jarekkt/UniController/README.md

# UniController

This is a off-spin from my commercial controller for industrial ink printers.
It is designed for pick & place machines controlled by OpenPnp
