jarekkt/UniController/hardware/12_mixture/UniMixBase/refs/3D/MB1430-G431KBT6-A02.step

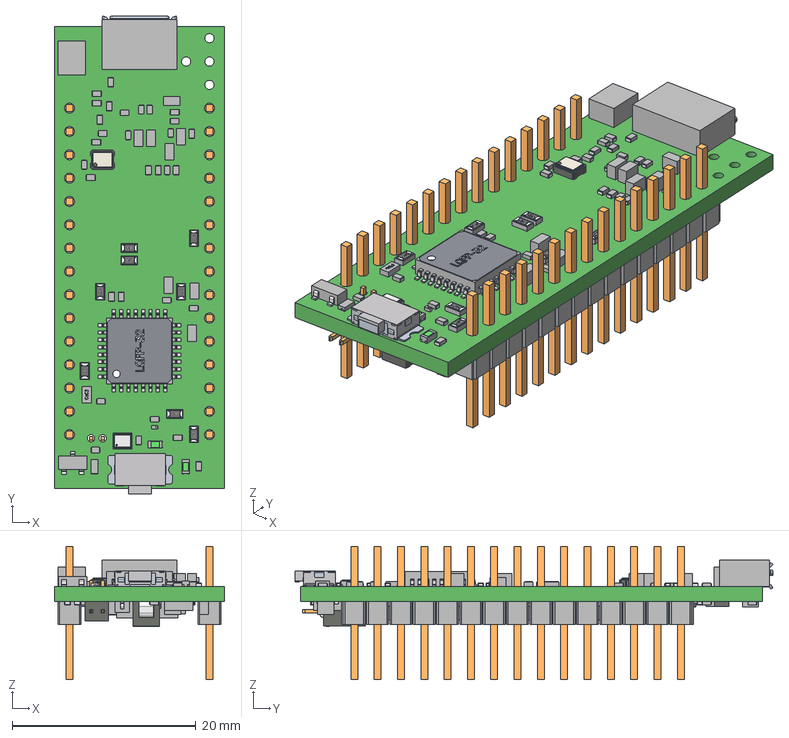
[picture p1: CAD file, 2025-05-28]
hardware/12_mixture/UniMixBase/refs/3D/MB1430-G431KBT6-A02.step
18.5 x 52.1 x 14.5 mm
Board
Extruded x 183
R0603 x 13
R0402 x 21
SOT23-3_TO-236AB
KSS221GLFS
NX2016
UFQFPN-32
SW3dPS-LQFP32_Board2 x 32
SW3dPS-LQFP32_Extruded15 x 32
SW3dPS-LQFP32_Extruded10
SW3dPS-LQFP32_Extruded16
SW3dPS-LQFP32_Extruded14
SW3dPS-LQFP32_Extruded11
SW3dPS-LQFP32_Extruded13
SW3dPS-LQFP32_Extruded19
SW3dPS-LQFP32_Extruded12
SW3dPS-LQFP32_Cylinder1
SW3dPS-LQFP32_Extruded18
SW3dPS-LQFP32_Extruded17
SW3dPS-LQFP32_Board3
DFN6-EPAD_3X3_P095
SOT223
SOT23-5L x 2
User_Library-LED_0603_G_Pocket002 x 2
User_Library-LED_0603_G_Pad004 x 2
User_Library-LED_0603_G_Fillet x 2
User_Library-LED_0603_G_Pocket001 x 2
User_Library-LED_0603_G_Pad x 2
LED_0603_RED_H0P4
L0603
SMA_DO214-AC
SOD323 x 3
C0402 x 32
C0603 x 13
C0805_2012D x 2
