jarekkt/UniController/hardware/12_mixture/UniMixBase/refs/3D/THVD1400DRLR.stp

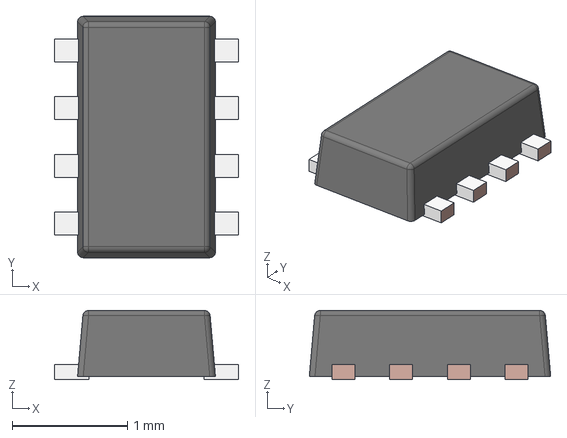
[picture p2: CAD file, 2025-02-07]
hardware/12_mixture/UniMixBase/refs/3D/THVD1400DRLR.stp
1.60 x 2.10 x 0.6 mm
FRAME-DRL0008A
BODY-SOT
