jarekkt/UniController/hardware/12_mixture/UniMixBase/refs/3D/XGZP6847A.STEP

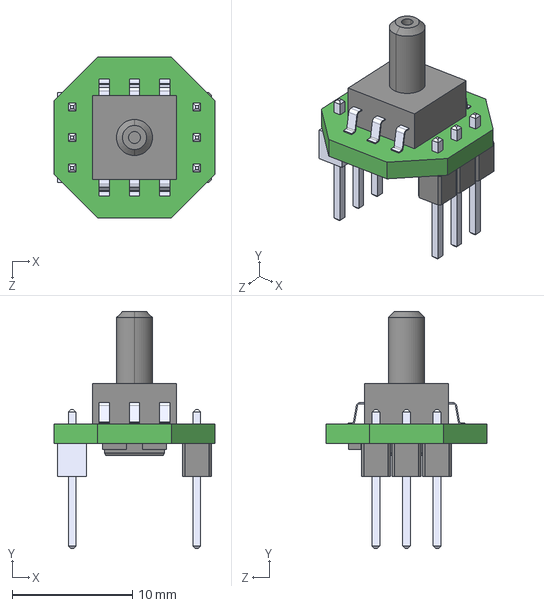
[picture p3: CAD file, 2025-02-07]
hardware/12_mixture/UniMixBase/refs/3D/XGZP6847A.STEP
13.4 x 19.7 x 13.3 mm
