jarekkt/UniController/hardware/12_mixture/UniMixBase/refs/3D/TMC2209_SILENTSTEPSTICK.step

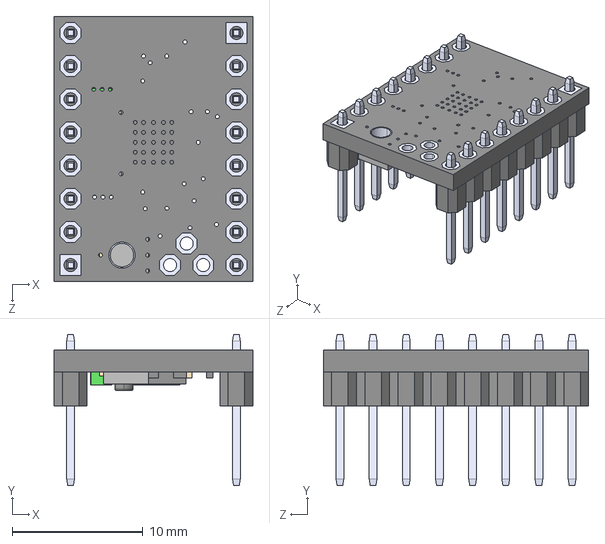
[picture p4: CAD file, 2025-02-07]
hardware/12_mixture/UniMixBase/refs/3D/TMC2209_SILENTSTEPSTICK.step
15.2 x 11.6 x 20.3 mm
