jarekkt/UniController/hardware/12_mixture/UniMixBase/refs/3D/3557-2.step

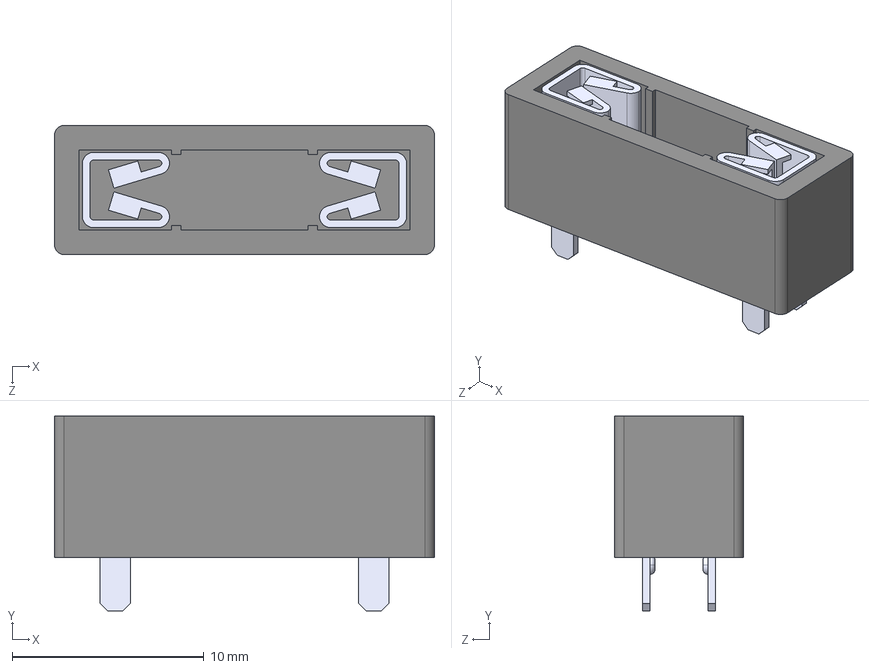
[picture p5: CAD file, 2025-02-07]
hardware/12_mixture/UniMixBase/refs/3D/3557-2.step
19.8 x 10.2 x 6.73 mm
