jarekkt/UniController/hardware/12_mixture/UniMixBase/refs/3D/LPC11C22FBD48_301,.stp

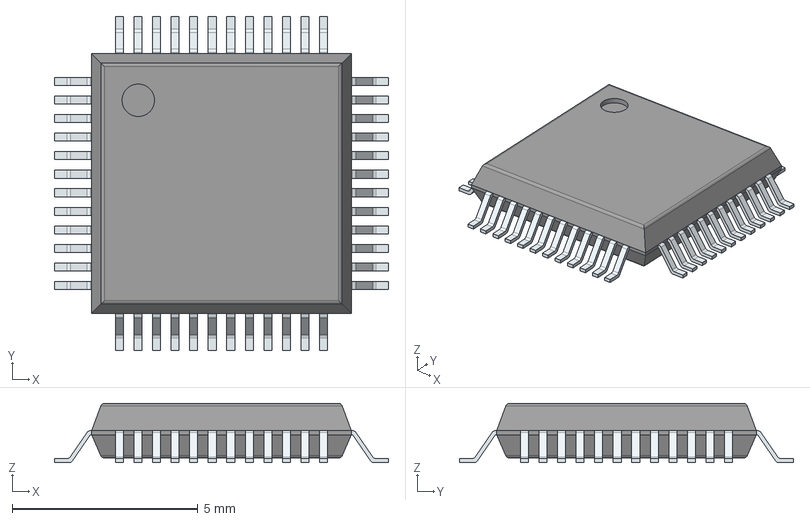
[picture p6: CAD file, 2025-02-07]
hardware/12_mixture/UniMixBase/refs/3D/LPC11C22FBD48_301,.stp
9.00 x 9.00 x 1.60 mm
PinsArrayLR
PinsArrayTB
