jarekkt/UniController/hardware/12_mixture/UniMixBase/refs/3D/D-SUN_dcdc_step_down_SIMPLE.step

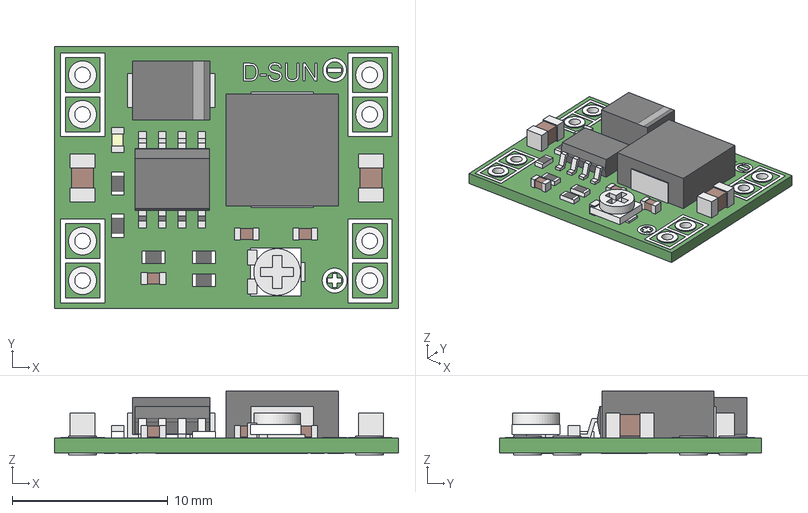
[picture p8: CAD file, 2025-02-07]
hardware/12_mixture/UniMixBase/refs/3D/D-SUN_dcdc_step_down_SIMPLE.step
22.1 x 16.8 x 4.10 mm
main001
silk-TOP
pins
silk-bot
comp-top
