jarekkt/UniController/hardware/12_mixture/UniMixBase/refs/3D/VNN3NV04PTR-E.stp

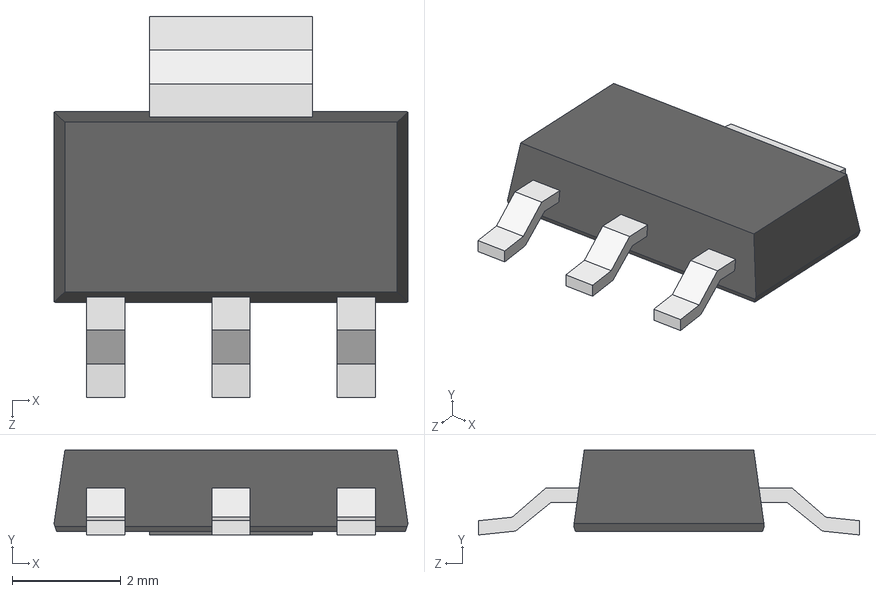
[picture p9: CAD file, 2025-02-07]
hardware/12_mixture/UniMixBase/refs/3D/VNN3NV04PTR-E.stp
6.50 x 1.56 x 7.00 mm
