jarekkt/UniController/hardware/12_mixture/UniMixBase/refs/3D/pxc_1990025_02_02_PTSA-0-5-4-2-5-Z_3D.stp

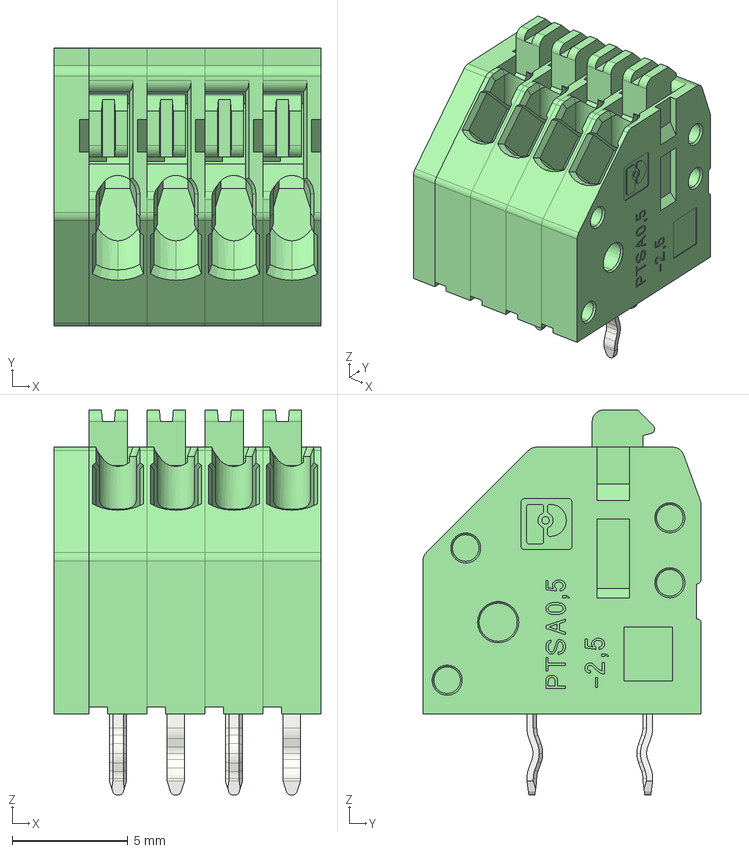
[picture p10: CAD file, 2025-02-07]
hardware/12_mixture/UniMixBase/refs/3D/pxc_1990025_02_02_PTSA-0-5-4-2-5-Z_3D.stp
11.5 x 12.0 x 16.6 mm
