jarekkt/UniController/hardware/12_mixture/UniMixBase/refs/3D/AP7375-50W5-7.stp

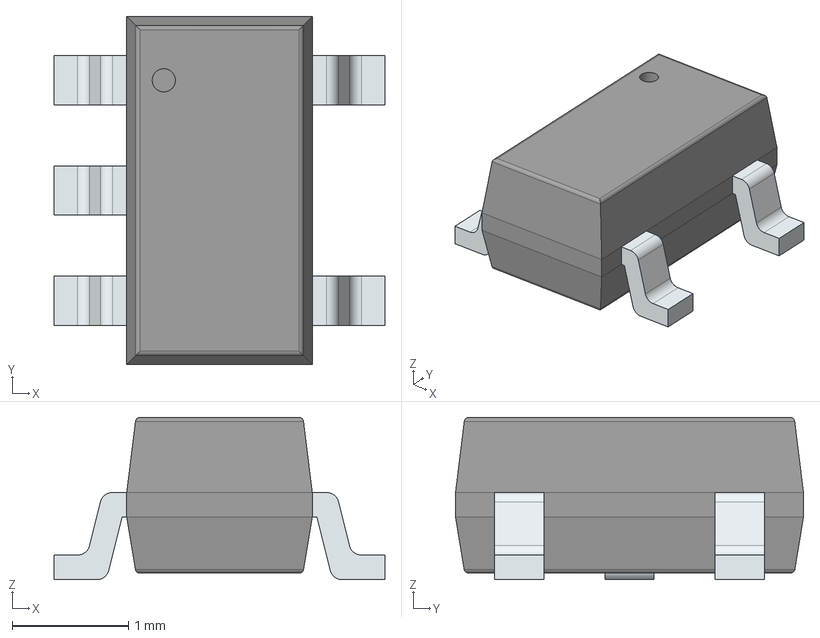
[picture p11: CAD file, 2024-10-20]
hardware/12_mixture/UniMixBase/refs/3D/AP7375-50W5-7.stp
2.85 x 3.00 x 1.40 mm
PinsArrayL
PinsArrayR
