jarekkt/UniController/hardware/12_mixture/UniMixBase/refs/3D/TMC2209-LA-T.stp

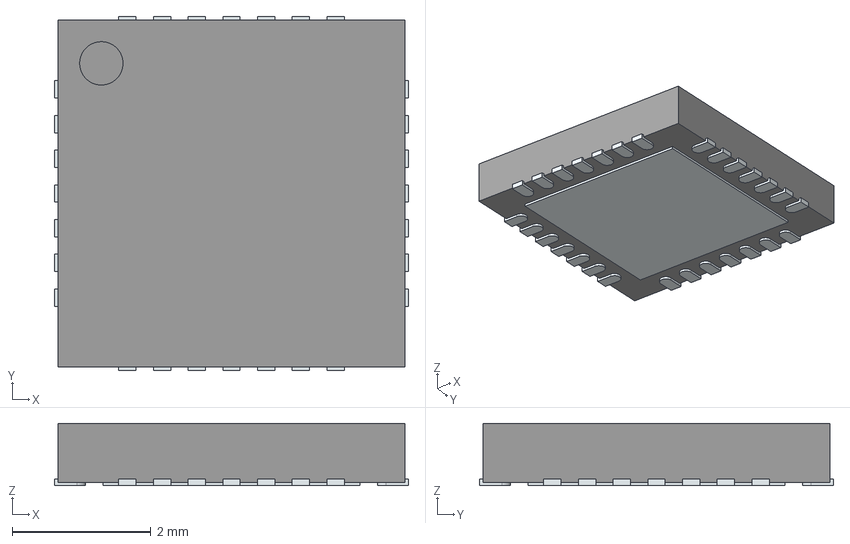
[picture p12: CAD file, 2024-10-20]
hardware/12_mixture/UniMixBase/refs/3D/TMC2209-LA-T.stp
5.10 x 5.10 x 0.9 mm
ThermalPin
PinsArrayLR
PinsArrayTB
