jarekkt/UniController/hardware/12_mixture/UniMixBase/refs/3D/05200101Z.stp

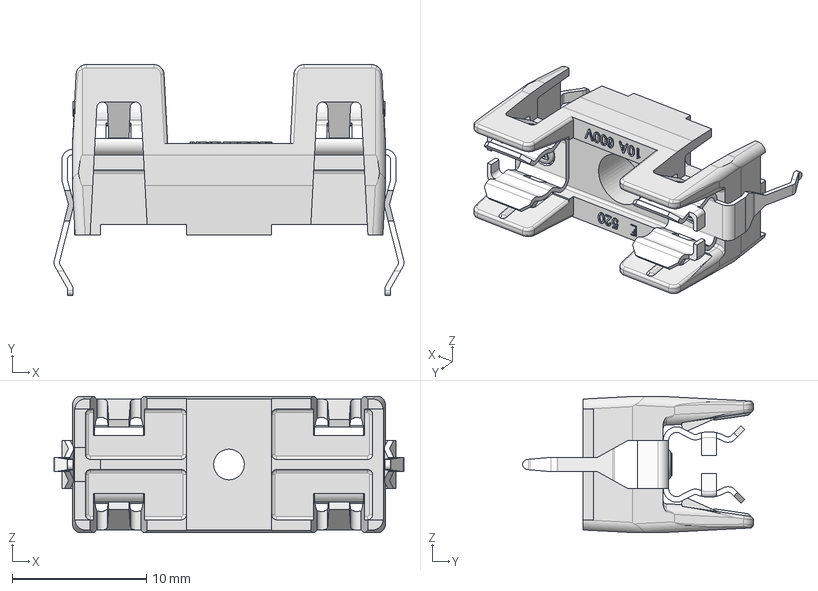
[picture p13: CAD file, 2025-02-07]
hardware/12_mixture/UniMixBase/refs/3D/05200101Z.stp
26.1 x 17.2 x 10.2 mm
111509_MIR
