jarekkt/UniController/hardware/12_mixture/UniMixHeadFd/UniMixHeadFd.kicad_pcb

## KiCad design hardware/12_mixture/UniMixHeadFd/UniMixHeadFd.kicad_pcb (2025-05-28)

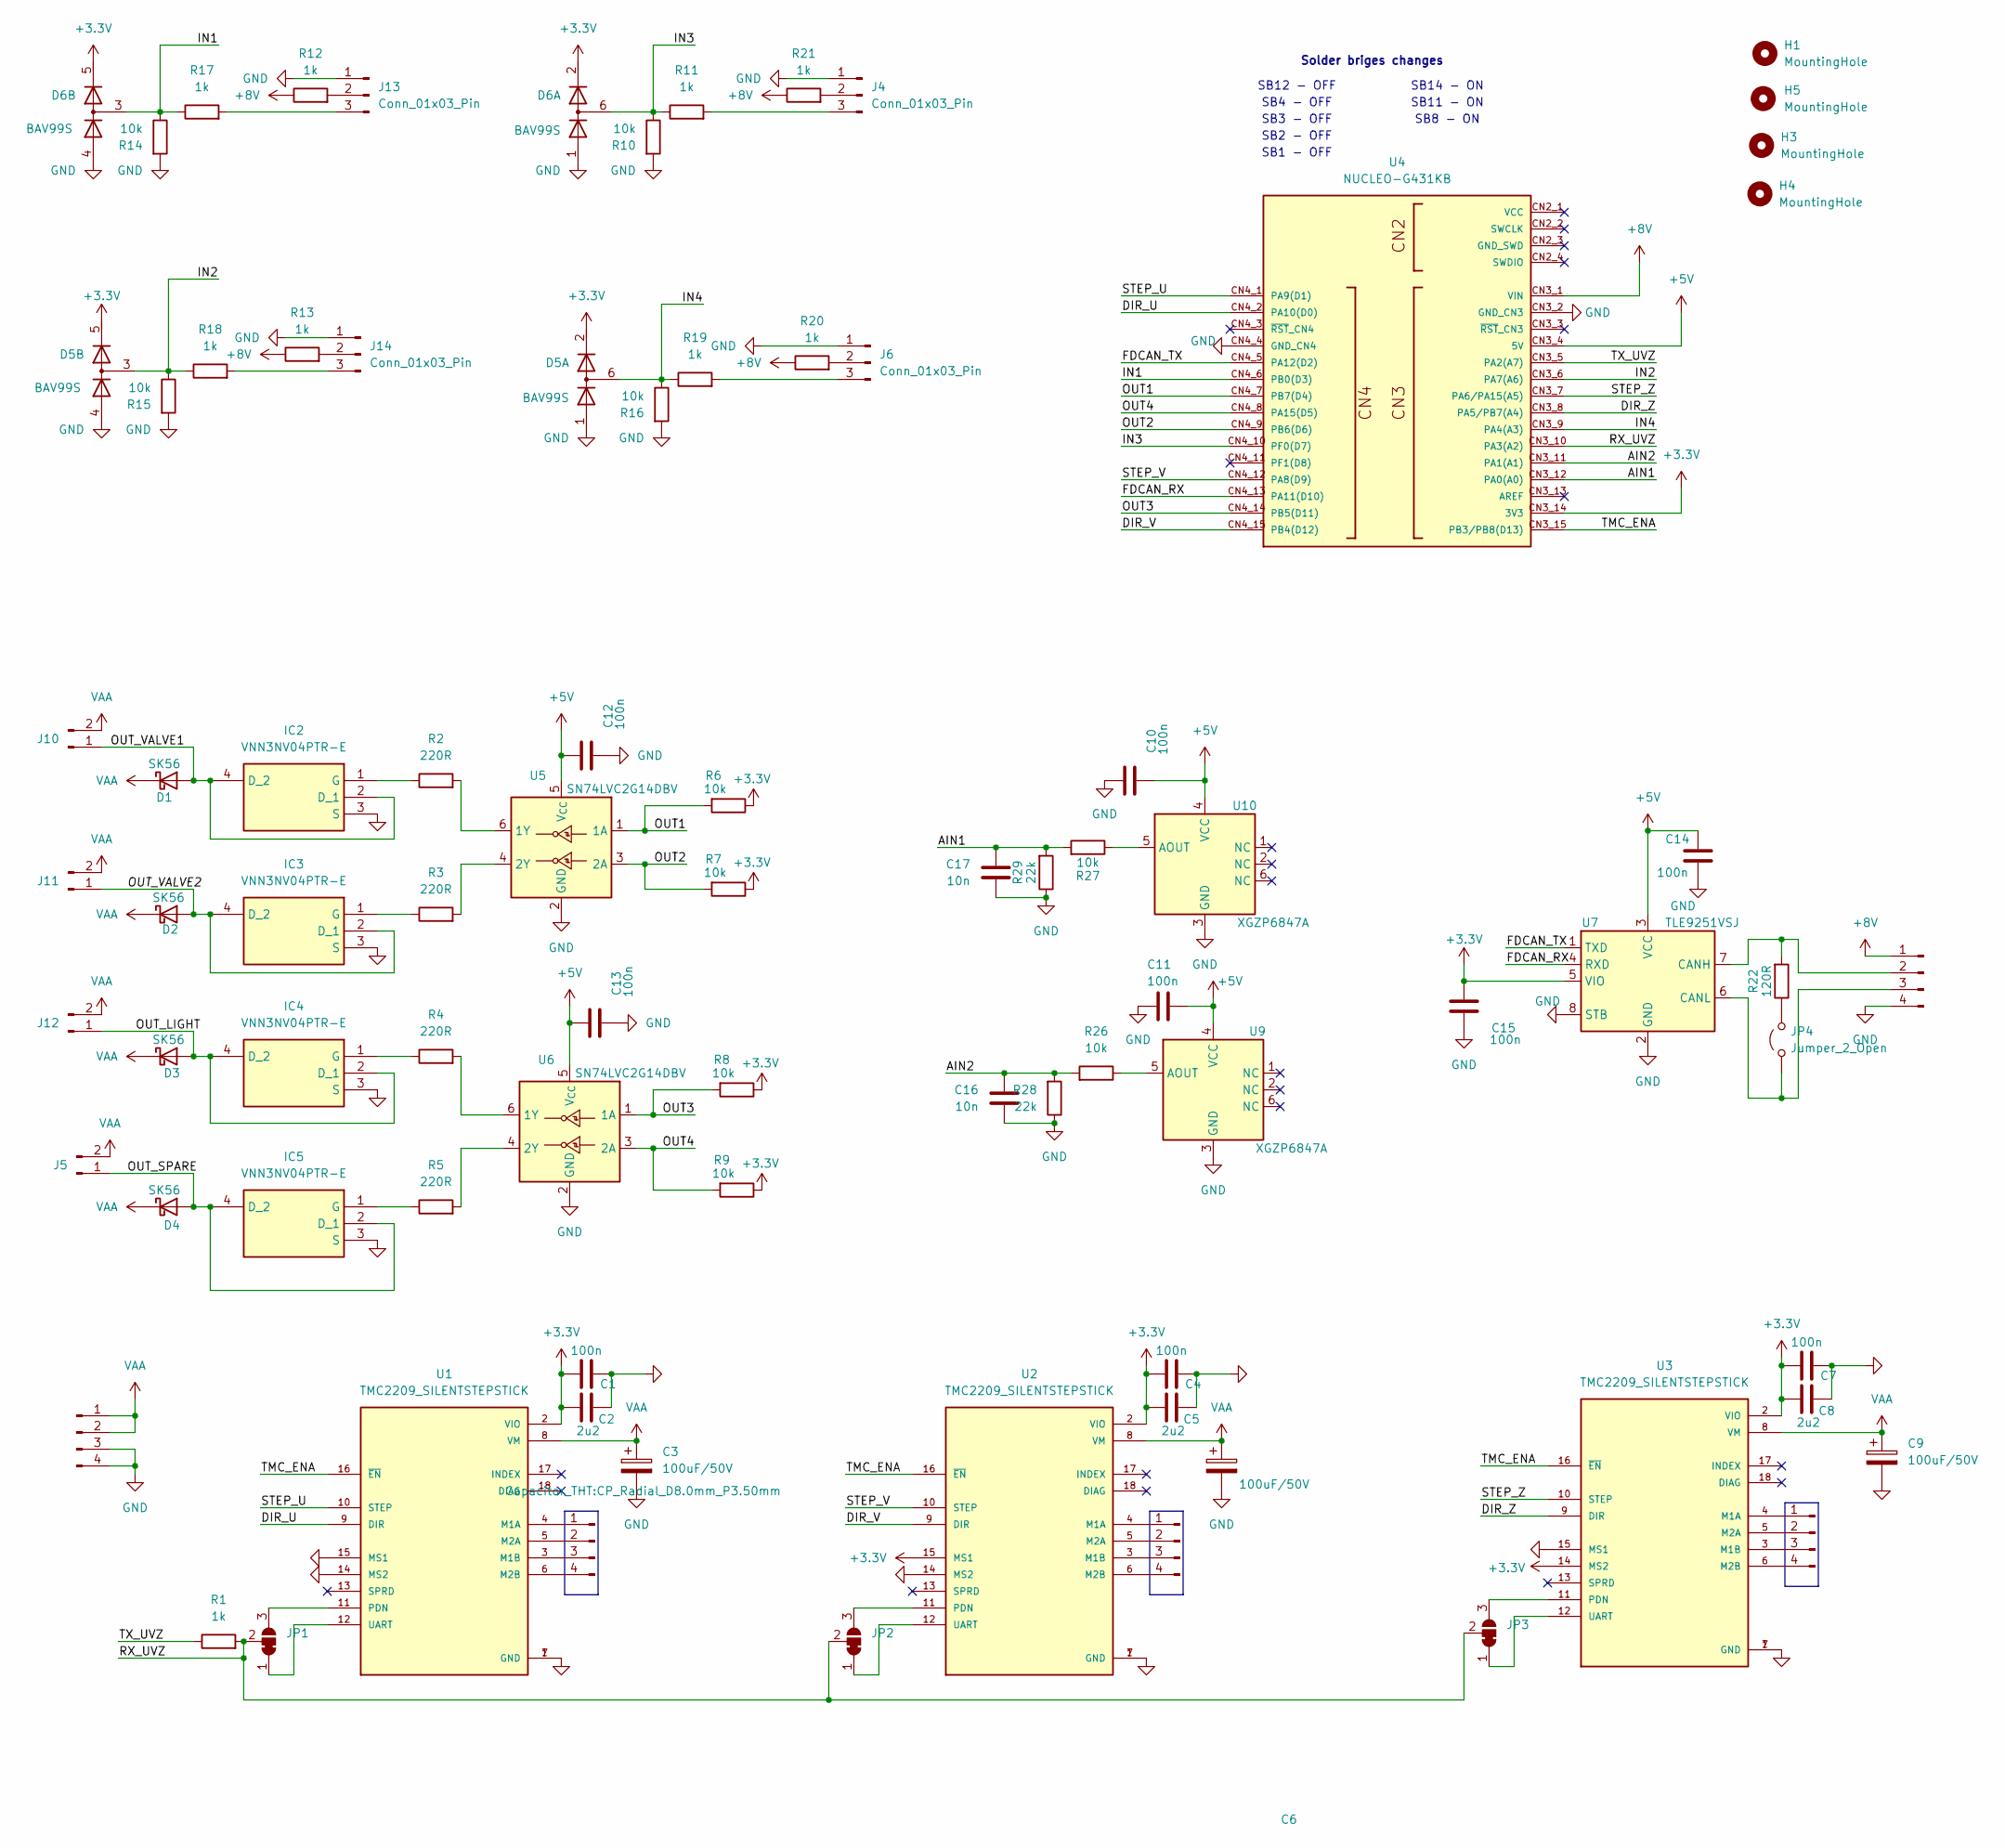
[picture p14: schematic UniMixHeadFd.kicad_sch]

Parts:
C1, C4, C7, C10, C11, C12, C13, C15: 100n; C_0603_1608Metric
C2, C5, C8: 2u2; C_0603_1608Metric
C3, C6, C9: 100uF/50V; CP_Radial_D8.0mm_P3.50mm
C14: 100n; C_0603_1608Metric; Digikey CC0402KRX7R7BB104
C16, C17: 10n; C_0603_1608Metric
D1, D2, D3, D4: SK56; D_SMB
D5, D6: BAV99S; SOT-363_SC-70-6
H1, H3, H4, H5: MountingHole; MountingHole_3.2mm_M3
IC2, IC3, IC4, IC5: VNN3NV04PTR-E; SOT230P700X180-4N; Manufacturer_Part_Number VNN3NV04PTR-E; Mouser Part Number 511-VNN3NV04PTR-E
J1, J2, J3, J25, J26: Conn_01x04_Male; JST_XH_B4B-XH-AM_1x04_P2.50mm_Vertical
J4, J6, J13, J14: Conn_01x03_Pin; JST_XH_B3B-XH-A_1x03_P2.50mm_Vertical
J5, J10, J11, J12: Conn_01x02_Male; JST_XH_B2B-XH-A_1x02_P2.50mm_Vertical
JP1, JP2, JP3: SolderJumper_3_Bridged12; SolderJumper-3_P1.3mm_Bridged12_RoundedPad1.0x1.5mm
JP4: Jumper_2_Open; SolderJumper-2_P1.3mm_Open_RoundedPad1.0x1.5mm
R1, R11, R12, R13, R17, R18, R19, R20, R21: 1k; R_0603_1608Metric
R2, R3, R4, R5: 220R; R_0603_1608Metric
R6, R7, R8, R9, R10, R14, R15, R16, R26, R27: 10k; R_0603_1608Metric
R22: 120R; R_1206_3216Metric
R28, R29: 22k; R_0603_1608Metric
U1, U2, U3: TMC2209_SILENTSTEPSTICK; MODULE_TMC2209_SILENTSTEPSTICK; PARTREV 1.20
U4: NUCLEO-G431KB; MODULE_NUCLEO-G431KB; PARTREV 2
U5, U6: SN74LVC2G14DBV; SOT-23-6
U7: TLE9251VSJ; SOIC-8_3.9x4.9mm_P1.27mm; Digikey TLE9251VSJXUMA1TR-ND
U9, U10: XGZP6847A; DIP-6_W10.16mm

Connections:
+3.3V: C1.2, C2.2, C4.2, C5.2, C7.2, C8.2, C15.1, D5.2 (K2), D5.5 (K4), D6.2 (K2), D6.5 (K4), R6.1, R7.1, R8.1, R9.1, U1.2 (VIO), U2.2 (VIO), U2.15 (MS1), U3.2 (VIO), U3.14 (MS2), U4.CN3_14 (3V3), U7.5 (VIO)
+5V: C10.2, C11.1, C12.1, C13.1, C14.1, U4.CN3_4 (5V), U5.5 (V_{CC}), U6.5 (V_{CC}), U7.3 (VCC), U9.4 (VCC), U10.4 (VCC)
+8V: J26.1, R12.1, R13.1, R20.1, R21.1, U4.CN3_1 (VIN)
/AIN1: C17.1, R27.2, R29.2, U4.CN3_12 (PA0(A0))
/AIN2: C16.1, R26.2, R28.2, U4.CN3_11 (PA1(A1))
/DIR_U: U1.9 (DIR), U4.CN4_2 (PA10(D0))
/DIR_V: U2.9 (DIR), U4.CN4_15 (PB4(D12))
/DIR_Z: U3.9 (DIR), U4.CN3_8 (PA5/PB7(A4))
/FDCAN_RX: U4.CN4_13 (PA11(D10)), U7.4 (RXD)
/FDCAN_TX: U4.CN4_5 (PA12(D2)), U7.1 (TXD)
/IN1: D6.3 (K1A2), R14.1, R17.1, U4.CN4_6 (PB0(D3))
/IN2: D5.3 (K1A2), R15.1, R18.1, U4.CN3_6 (PA7(A6))
/IN3: D6.6 (K3A4), R10.1, R11.1, U4.CN4_10 (PF0(D7))
/IN4: D5.6 (K3A4), R16.1, R19.1, U4.CN3_9 (PA4(A3))
/OUT1: R6.2, U4.CN4_7 (PB7(D4)), U5.1 (1A)
/OUT2: R7.2, U4.CN4_9 (PB6(D6)), U5.3 (2A)
/OUT3: R8.2, U4.CN4_14 (PB5(D11)), U6.1 (1A)
/OUT4: R9.2, U4.CN4_8 (PA15(D5)), U6.3 (2A)
/OUT_LIGHT: D3.2 (A), IC4.2 (D_1), IC4.4 (D_2), J12.1
/OUT_SPARE: D4.2 (A), IC5.2 (D_1), IC5.4 (D_2), J5.1
/OUT_VALVE1: D1.2 (A), IC2.2 (D_1), IC2.4 (D_2), J10.1
/OUT_VALVE2: D2.2 (A), IC3.2 (D_1), IC3.4 (D_2), J11.1
/RX_UVZ: JP1.2 (C), JP2.2 (C), JP3.2 (C), R1.2, U4.CN3_10 (PA3(A2))
/STEP_U: U1.10 (STEP), U4.CN4_1 (PA9(D1))
/STEP_V: U2.10 (STEP), U4.CN4_12 (PA8(D9))
/STEP_Z: U3.10 (STEP), U4.CN3_7 (PA6/PA15(A5))
/TMC_ENA: U1.16 (~EN), U2.16 (~EN), U3.16 (~EN), U4.CN3_15 (PB3/PB8(D13))
/TX_UVZ: R1.1, U4.CN3_5 (PA2(A7))
GND: C1.1, C2.1, C3.2, C4.1, C5.1, C6.2, C7.1, C8.1, C9.2, C10.1, C11.2, C12.2, C13.2, C14.2, C15.2, C16.2, C17.2, D5.1 (A1), D5.4 (A3), D6.1 (A1), D6.4 (A3), IC2.3 (S), IC3.3 (S), IC4.3 (S), IC5.3 (S), J4.1, J6.1, J13.1, J14.1, J25.3, J25.4, J26.4, R10.2, R14.2, R15.2, R16.2, R28.1, R29.1, U1.1 (GND), U1.7 (GND), U1.14 (MS2), U1.15 (MS1), U2.1 (GND), U2.7 (GND), U2.14 (MS2), U3.1 (GND), U3.7 (GND), U3.15 (MS1), U4.CN3_2 (GND_CN3), U4.CN4_4 (GND_CN4), U5.2 (GND), U6.2 (GND), U7.2 (GND), U7.8 (STB), U9.3 (GND), U10.3 (GND)
unnamed: IC2.1 (G), R2.1
unnamed: IC3.1 (G), R3.1
unnamed: IC4.1 (G), R4.1
unnamed: IC5.1 (G), R5.1
unnamed: J1.1, U1.4 (M1A)
unnamed: J1.2, U1.5 (M2A)
unnamed: J1.3, U1.3 (M1B)
unnamed: J1.4, U1.6 (M2B)
unnamed: J2.1, U2.4 (M1A)
unnamed: J2.2, U2.5 (M2A)
unnamed: J2.3, U2.3 (M1B)
unnamed: J2.4, U2.6 (M2B)
unnamed: J3.1, U3.4 (M1A)
unnamed: J3.2, U3.5 (M2A)
unnamed: J3.3, U3.3 (M1B)
unnamed: J3.4, U3.6 (M2B)
unnamed: J4.2, R21.2
unnamed: J4.3, R11.2
unnamed: J6.2, R20.2
unnamed: J6.3, R19.2
unnamed: J13.2, R12.2
unnamed: J13.3, R17.2
unnamed: J14.2, R13.2
unnamed: J14.3, R18.2
unnamed: J26.2, R22.2, U7.7 (CANH)
unnamed: J26.3, JP4.1 (A), U7.6 (CANL)
unnamed: JP1.1 (A), U1.12 (UART)
unnamed: JP1.3 (B), U1.11 (PDN)
unnamed: JP2.1 (A), U2.12 (UART)
unnamed: JP2.3 (B), U2.11 (PDN)
unnamed: JP3.1 (A), U3.12 (UART)
unnamed: JP3.3 (B), U3.11 (PDN)
unnamed: JP4.2 (B), R22.1
unnamed: R2.2, U5.6 (1Y)
unnamed: R3.2, U5.4 (2Y)
unnamed: R4.2, U6.6 (1Y)
unnamed: R5.2, U6.4 (2Y)
unnamed: R26.1, U9.5 (AOUT)
unnamed: R27.1, U10.5 (AOUT)
VAA: C3.1, C6.1, C9.1, D1.1 (K), D2.1 (K), D3.1 (K), D4.1 (K), J5.2, J10.2, J11.2, J12.2, J25.1, J25.2, U1.8 (VM), U2.8 (VM), U3.8 (VM)

Notes on the sheet:
SB8 - ON
SB3 - OFF
SB14 - ON
SB1 - OFF
SB11 - ON
SB4 - OFF
SB2 - OFF
SB12 - OFF
Solder briges changes

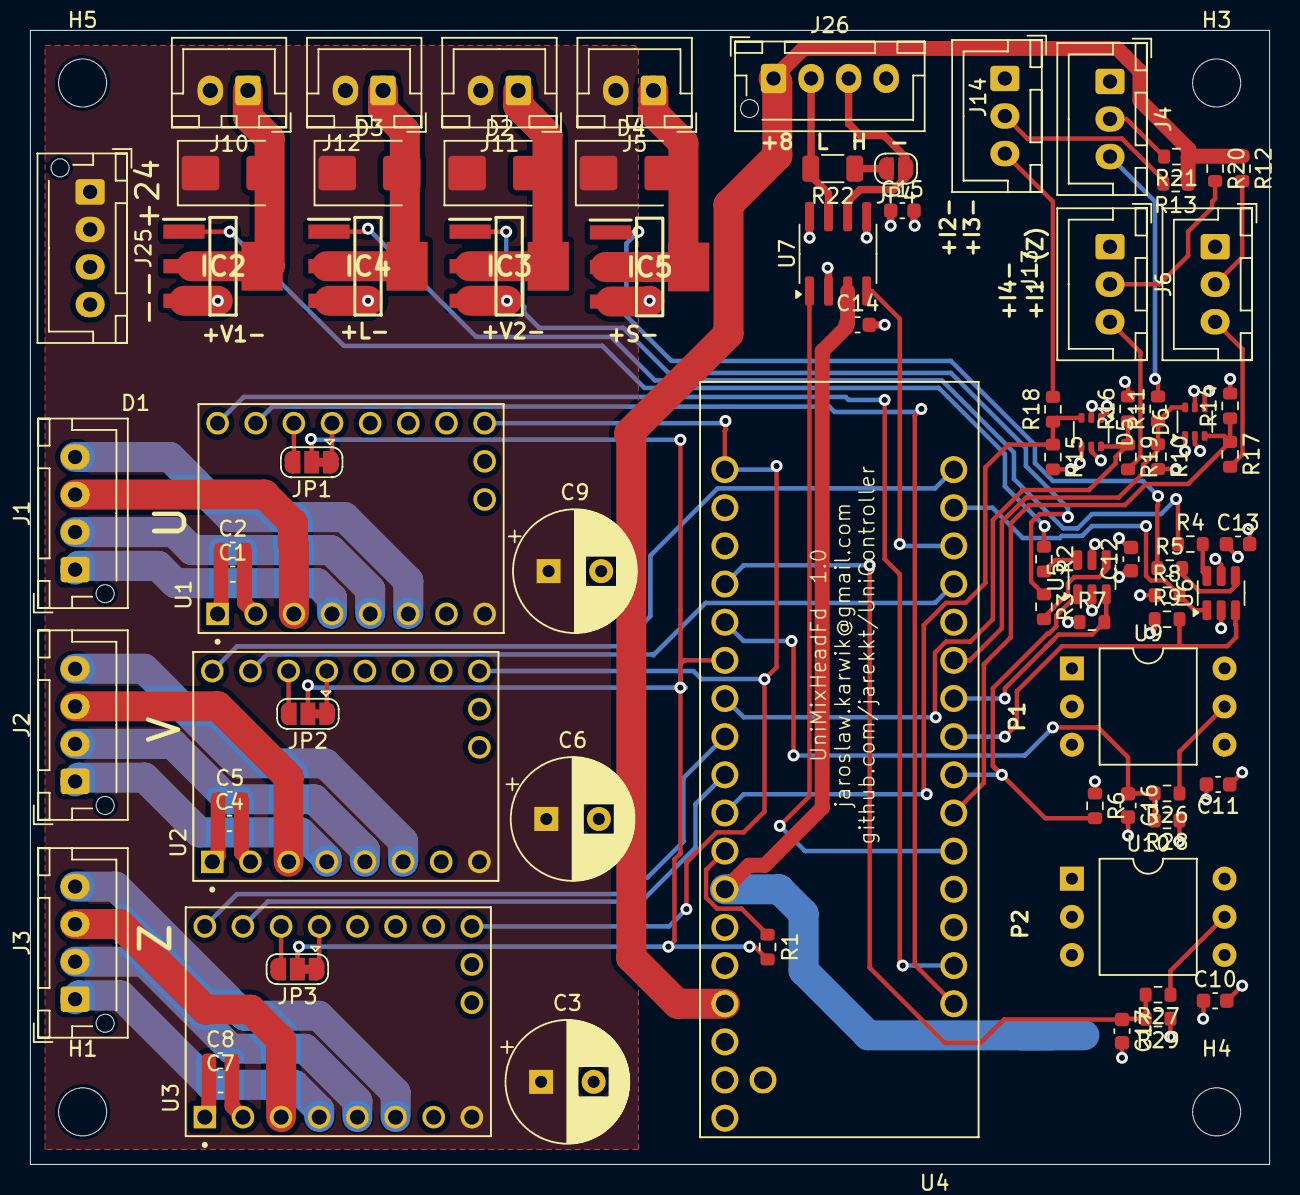
[picture p15: board UniMixHeadFd.kicad_pcb from above]

Board: 4 copper layers, 82.5 x 75.5 mm, 83 parts (0 on the bottom side), 69 nets.
