jarekkt/UniController/hardware/12_mixture/UniMixFeeders/UniMixFeeders.kicad_pcb

## KiCad design hardware/12_mixture/UniMixFeeders/UniMixFeeders.kicad_pcb (2025-05-28)

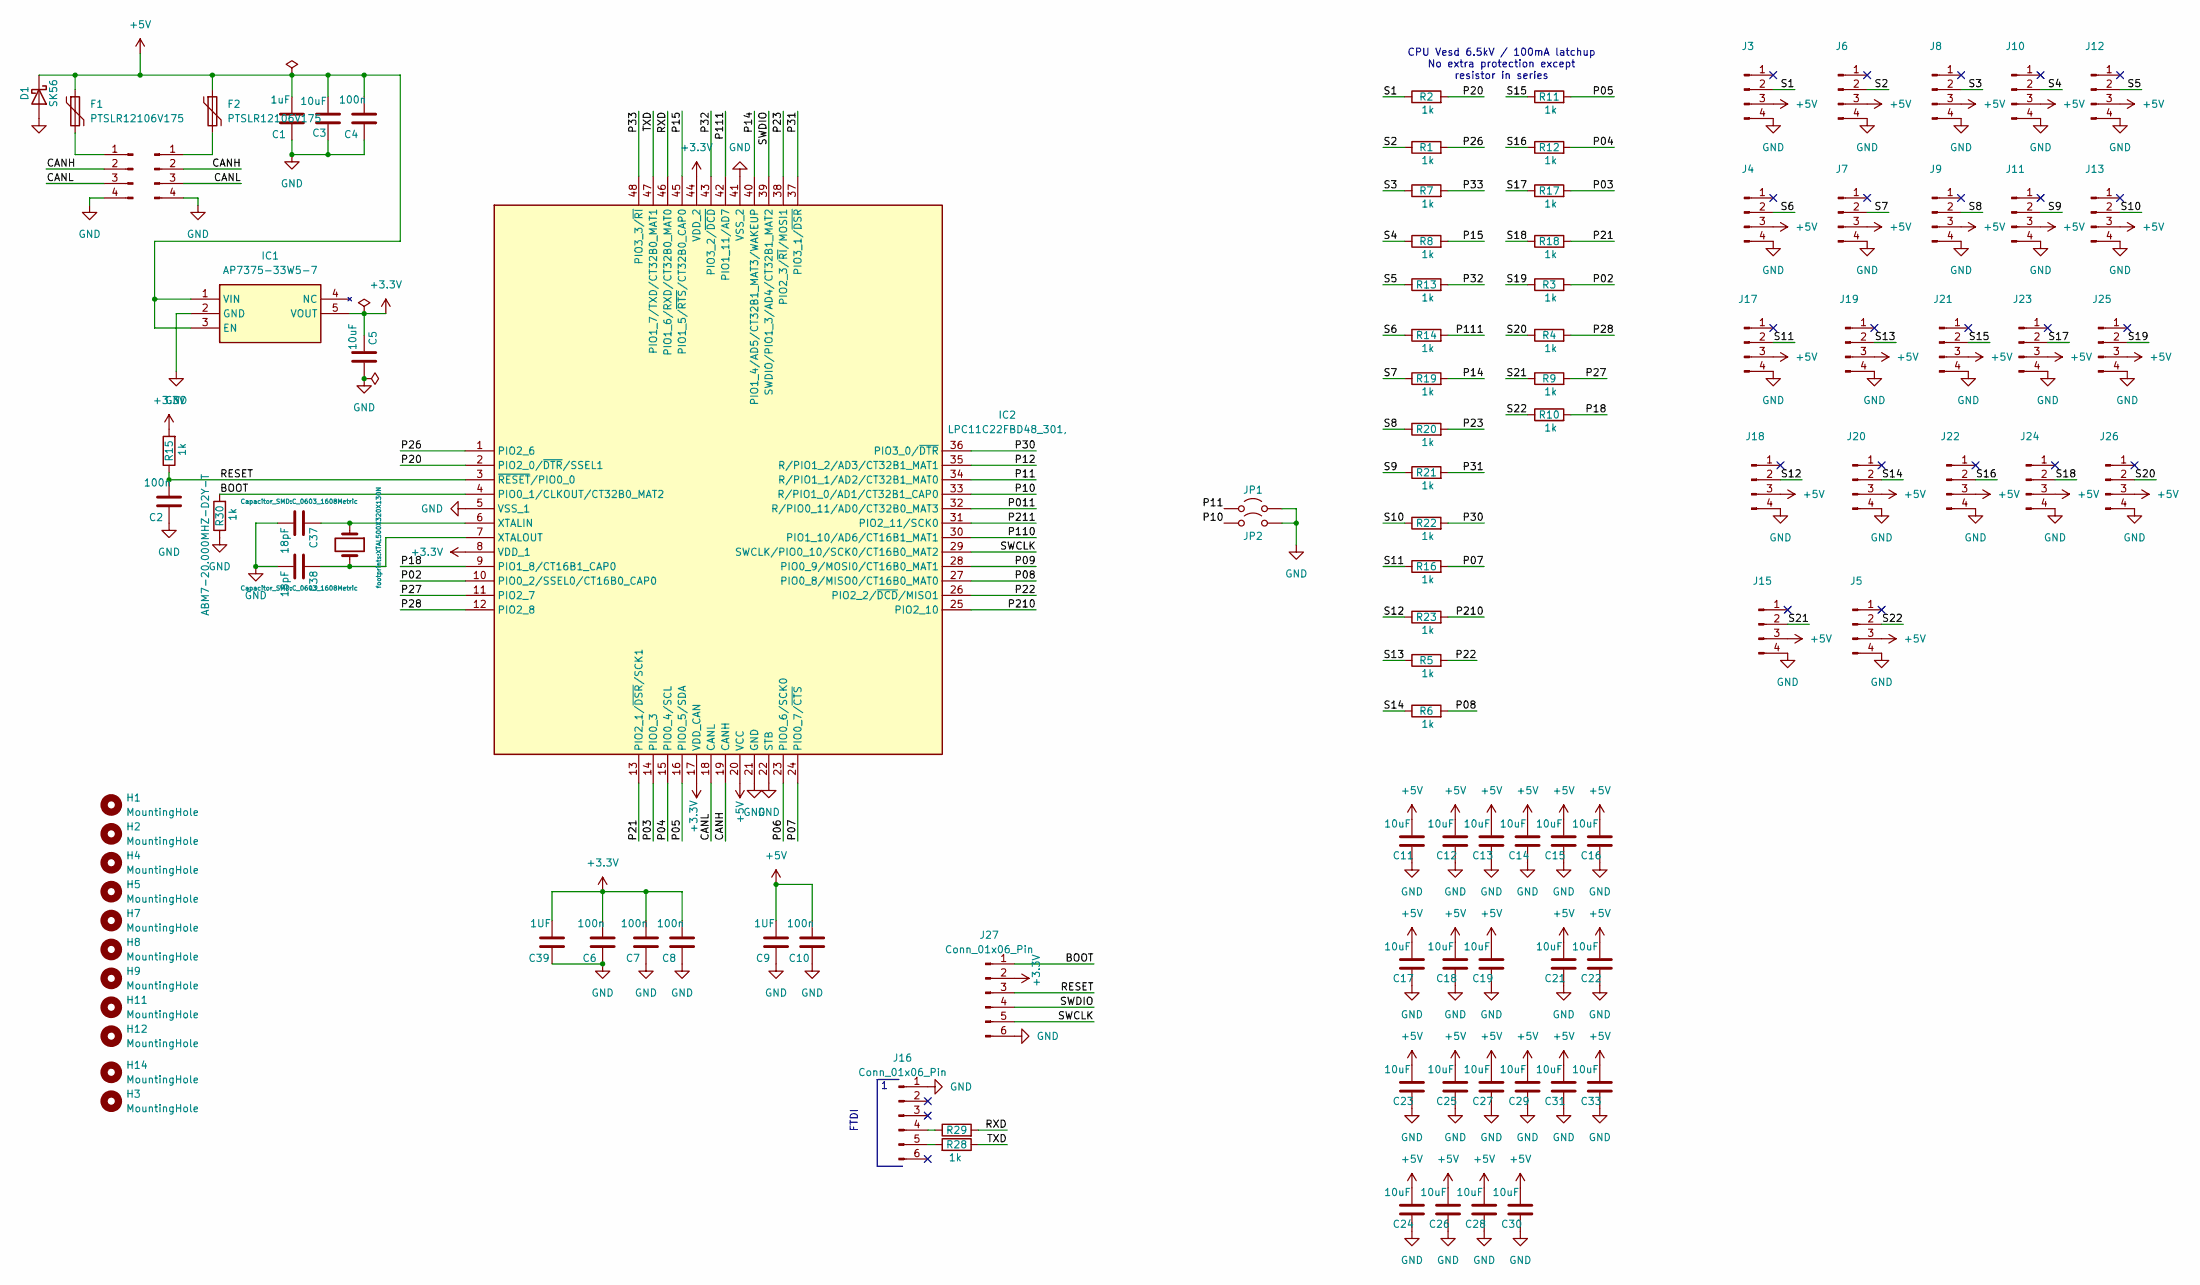
[picture p16: schematic UniMixFeeders.kicad_sch]

Parts:
C1: 1uF; C_0603_1608Metric
C2, C4, C6, C7, C8, C10: 100n; C_0603_1608Metric
C3, C5, C11, C12, C13, C14, C15, C16, C17, C18, C19, C21, C22, C23, C24, C25, C26, C27, C28, C29, C30, C31, C33: 10uF; C_1206_3216Metric
C9, C39: 1UF; C_0603_1608Metric
C37, C38: 18pF; C_0603_1608Metric
D1: SK56; D_SMB
F1, F2: PTSLR12106V175; Fuse_1210_3225Metric
H1, H2, H3, H4, H5, H7, H8, H9, H11, H12, H14: MountingHole; MountingHole_3.2mm_M3
IC1: AP7375-33W5-7; SOT95P285X140-5N
IC2: LPC11C22FBD48_301,; QFP50P900X900X160-48N; Manufacturer_Part_Number LPC11C22FBD48/301,; Mouser Part Number 771-LPC11C22FBD4830
J1, J2: Conn_01x04_Male; JST_XH_B4B-XH-AM_1x04_P2.50mm_Vertical
J3, J4, J5, J6, J7, J8, J9, J10, J11, J12, J13, J15, J17, J18, J19, J20, J21, J22, J23, J24, J25, J26: Conn_01x04_Pin; PinHeader_1x04_P2.54mm_Vertical
J16: Conn_01x06_Pin; PinHeader_1x06_P2.54mm_Vertical
J27: Conn_01x06_Pin; PinHeader_2x03_P2.54mm_Vertical
JP1, JP2: Jumper_2_Open; SolderJumper-2_P1.3mm_Open_RoundedPad1.0x1.5mm
R1, R2, R3, R4, R5, R6, R7, R8, R9, R10, R11, R12, R13, R14, R15, R16, R17, R18, R19, R20, R21, R22, R23, R28, R29, R30: 1k; R_0603_1608Metric
Y1: ABM7-20.000MHZ-D2Y-T; XTAL500X320X130N; Digikey 535-9843-2-ND

Connections:
+3.3V: C5.1, C6.1, C7.1, C8.1, C39.1, IC1.5 (VOUT), IC2.8 (VDD_1), IC2.17 (VDD_CAN), IC2.44 (VDD_2), J27.2, R15.2
+5V: C1.1, C3.1, C4.1, C9.1, C10.1, C11.1, C12.1, C13.1, C14.1, C15.1, C16.1, C17.1, C18.1, C19.1, C21.1, C22.1, C23.1, C24.1, C25.1, C26.1, C27.1, C28.1, C29.1, C30.1, C31.1, C33.1, D1.1 (K), F1.1, F2.1, IC1.1 (VIN), IC1.3 (EN), IC2.20 (VCC), J3.3, J4.3, J5.3, J6.3, J7.3, J8.3, J9.3, J10.3, J11.3, J12.3, J13.3, J15.3, J17.3, J18.3, J19.3, J20.3, J21.3, J22.3, J23.3, J24.3, J25.3, J26.3
/BOOT: IC2.4 (PIO0_1/CLKOUT/CT32B0_MAT2), J27.1, R30.2
/CANH: IC2.19 (CANH), J1.2, J2.2
/CANL: IC2.18 (CANL), J1.3, J2.3
/P02: IC2.10 (PIO0_2/SSEL0/CT16B0_CAP0), R3.2
/P03: IC2.14 (PIO0_3), R17.2
/P04: IC2.15 (PIO0_4/SCL), R12.2
/P05: IC2.16 (PIO0_5/SDA), R11.2
/P06: IC2.23 (PIO0_6/SCK0)
/P07: IC2.24 (PIO0_7/~CTS), R16.2
/P08: IC2.27 (PIO0_8/MISO0/CT16B0_MAT0), R6.2
/P09: IC2.28 (PIO0_9/MOSI0/CT16B0_MAT1)
/P10: IC2.33 (R/PIO1_0/AD1/CT32B1_CAP0), JP2.1 (A)
/P011: IC2.32 (R/PIO0_11/AD0/CT32B0_MAT3)
/P11: IC2.34 (R/PIO1_1/AD2/CT32B1_MAT0), JP1.1 (A)
/P12: IC2.35 (R/PIO1_2/AD3/CT32B1_MAT1)
/P14: IC2.40 (PIO1_4/AD5/CT32B1_MAT3/WAKEUP), R19.2
/P15: IC2.45 (PIO1_5/~RTS/CT32B0_CAP0), R8.2
/P18: IC2.9 (PIO1_8/CT16B1_CAP0), R10.2
/P20: IC2.2 (PIO2_0/~DTR/SSEL1), R2.2
/P21: IC2.13 (PIO2_1/~DSR/SCK1), R18.2
/P22: IC2.26 (PIO2_2/~DCD/MISO1), R5.2
/P23: IC2.38 (PIO2_3/~RI/MOSI1), R20.2
/P26: IC2.1 (PIO2_6), R1.2
/P27: IC2.11 (PIO2_7), R9.2
/P28: IC2.12 (PIO2_8), R4.2
/P30: IC2.36 (PIO3_0/~DTR), R22.2
/P31: IC2.37 (PIO3_1/~DSR), R21.2
/P32: IC2.43 (PIO3_2/~DCD), R13.2
/P33: IC2.48 (PIO3_3/~RI), R7.2
/P110: IC2.30 (PIO1_10/AD6/CT16B1_MAT1)
/P111: IC2.42 (PIO1_11/AD7), R14.2
/P210: IC2.25 (PIO2_10), R23.2
/P211: IC2.31 (PIO2_11/SCK0)
/RESET: C2.1, IC2.3 (~RESET/PIO0_0), J27.3, R15.1
/RXD: IC2.46 (PIO1_6/RXD/CT32B0_MAT0), R29.2
/S1: J3.2, R2.1
/S2: J6.2, R1.1
/S3: J8.2, R7.1
/S4: J10.2, R8.1
/S5: J12.2, R13.1
/S6: J4.2, R14.1
/S7: J7.2, R19.1
/S8: J9.2, R20.1
/S9: J11.2, R21.1
/S10: J13.2, R22.1
/S11: J17.2, R16.1
/S12: J18.2, R23.1
/S13: J19.2, R5.1
/S14: J20.2, R6.1
/S15: J21.2, R11.1
/S16: J22.2, R12.1
/S17: J23.2, R17.1
/S18: J24.2, R18.1
/S19: J25.2, R3.1
/S20: J26.2, R4.1
/S21: J15.2, R9.1
/S22: J5.2, R10.1
/SWCLK: IC2.29 (SWCLK/PIO0_10/SCK0/CT16B0_MAT2), J27.5
/SWDIO: IC2.39 (SWDIO/PIO1_3/AD4/CT32B1_MAT2), J27.4
/TXD: IC2.47 (PIO1_7/TXD/CT32B0_MAT1), R28.1
GND: C1.2, C2.2, C3.2, C4.2, C5.2, C6.2, C7.2, C8.2, C9.2, C10.2, C11.2, C12.2, C13.2, C14.2, C15.2, C16.2, C17.2, C18.2, C19.2, C21.2, C22.2, C23.2, C24.2, C25.2, C26.2, C27.2, C28.2, C29.2, C30.2, C31.2, C33.2, C37.2, C38.2, C39.2, D1.2 (A), IC1.2 (GND), IC2.5 (VSS_1), IC2.21 (GND), IC2.22 (STB), IC2.41 (VSS_2), J1.4, J2.4, J3.4, J4.4, J5.4, J6.4, J7.4, J8.4, J9.4, J10.4, J11.4, J12.4, J13.4, J15.4, J16.1, J17.4, J18.4, J19.4, J20.4, J21.4, J22.4, J23.4, J24.4, J25.4, J26.4, J27.6, JP1.2 (B), JP2.2 (B), R30.1
unnamed: C37.1, IC2.6 (XTALIN), Y1.1
unnamed: C38.1, IC2.7 (XTALOUT), Y1.2
unnamed: F1.2, J1.1
unnamed: F2.2, J2.1
unnamed: J16.4, R29.1
unnamed: J16.5, R28.2

Notes on the sheet:
CPU Vesd 6.5kV / 100mA latchup No extra protection except resistor in series
FTDI

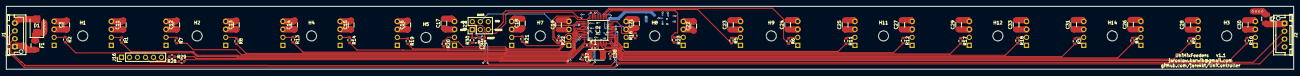
[picture p17: board UniMixFeeders.kicad_pcb from above]

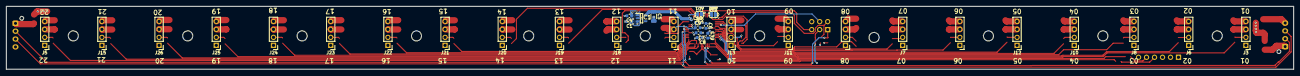
[picture p18: board UniMixFeeders.kicad_pcb from below]

Board: 4 copper layers, 409.6 x 20.0 mm, 105 parts (34 on the bottom side), 63 nets.
