jarekkt/UniController/hardware/12_mixture/UniMixBase/UniMixBase.kicad_pcb

## KiCad design hardware/12_mixture/UniMixBase/UniMixBase.kicad_pcb (2025-05-28)

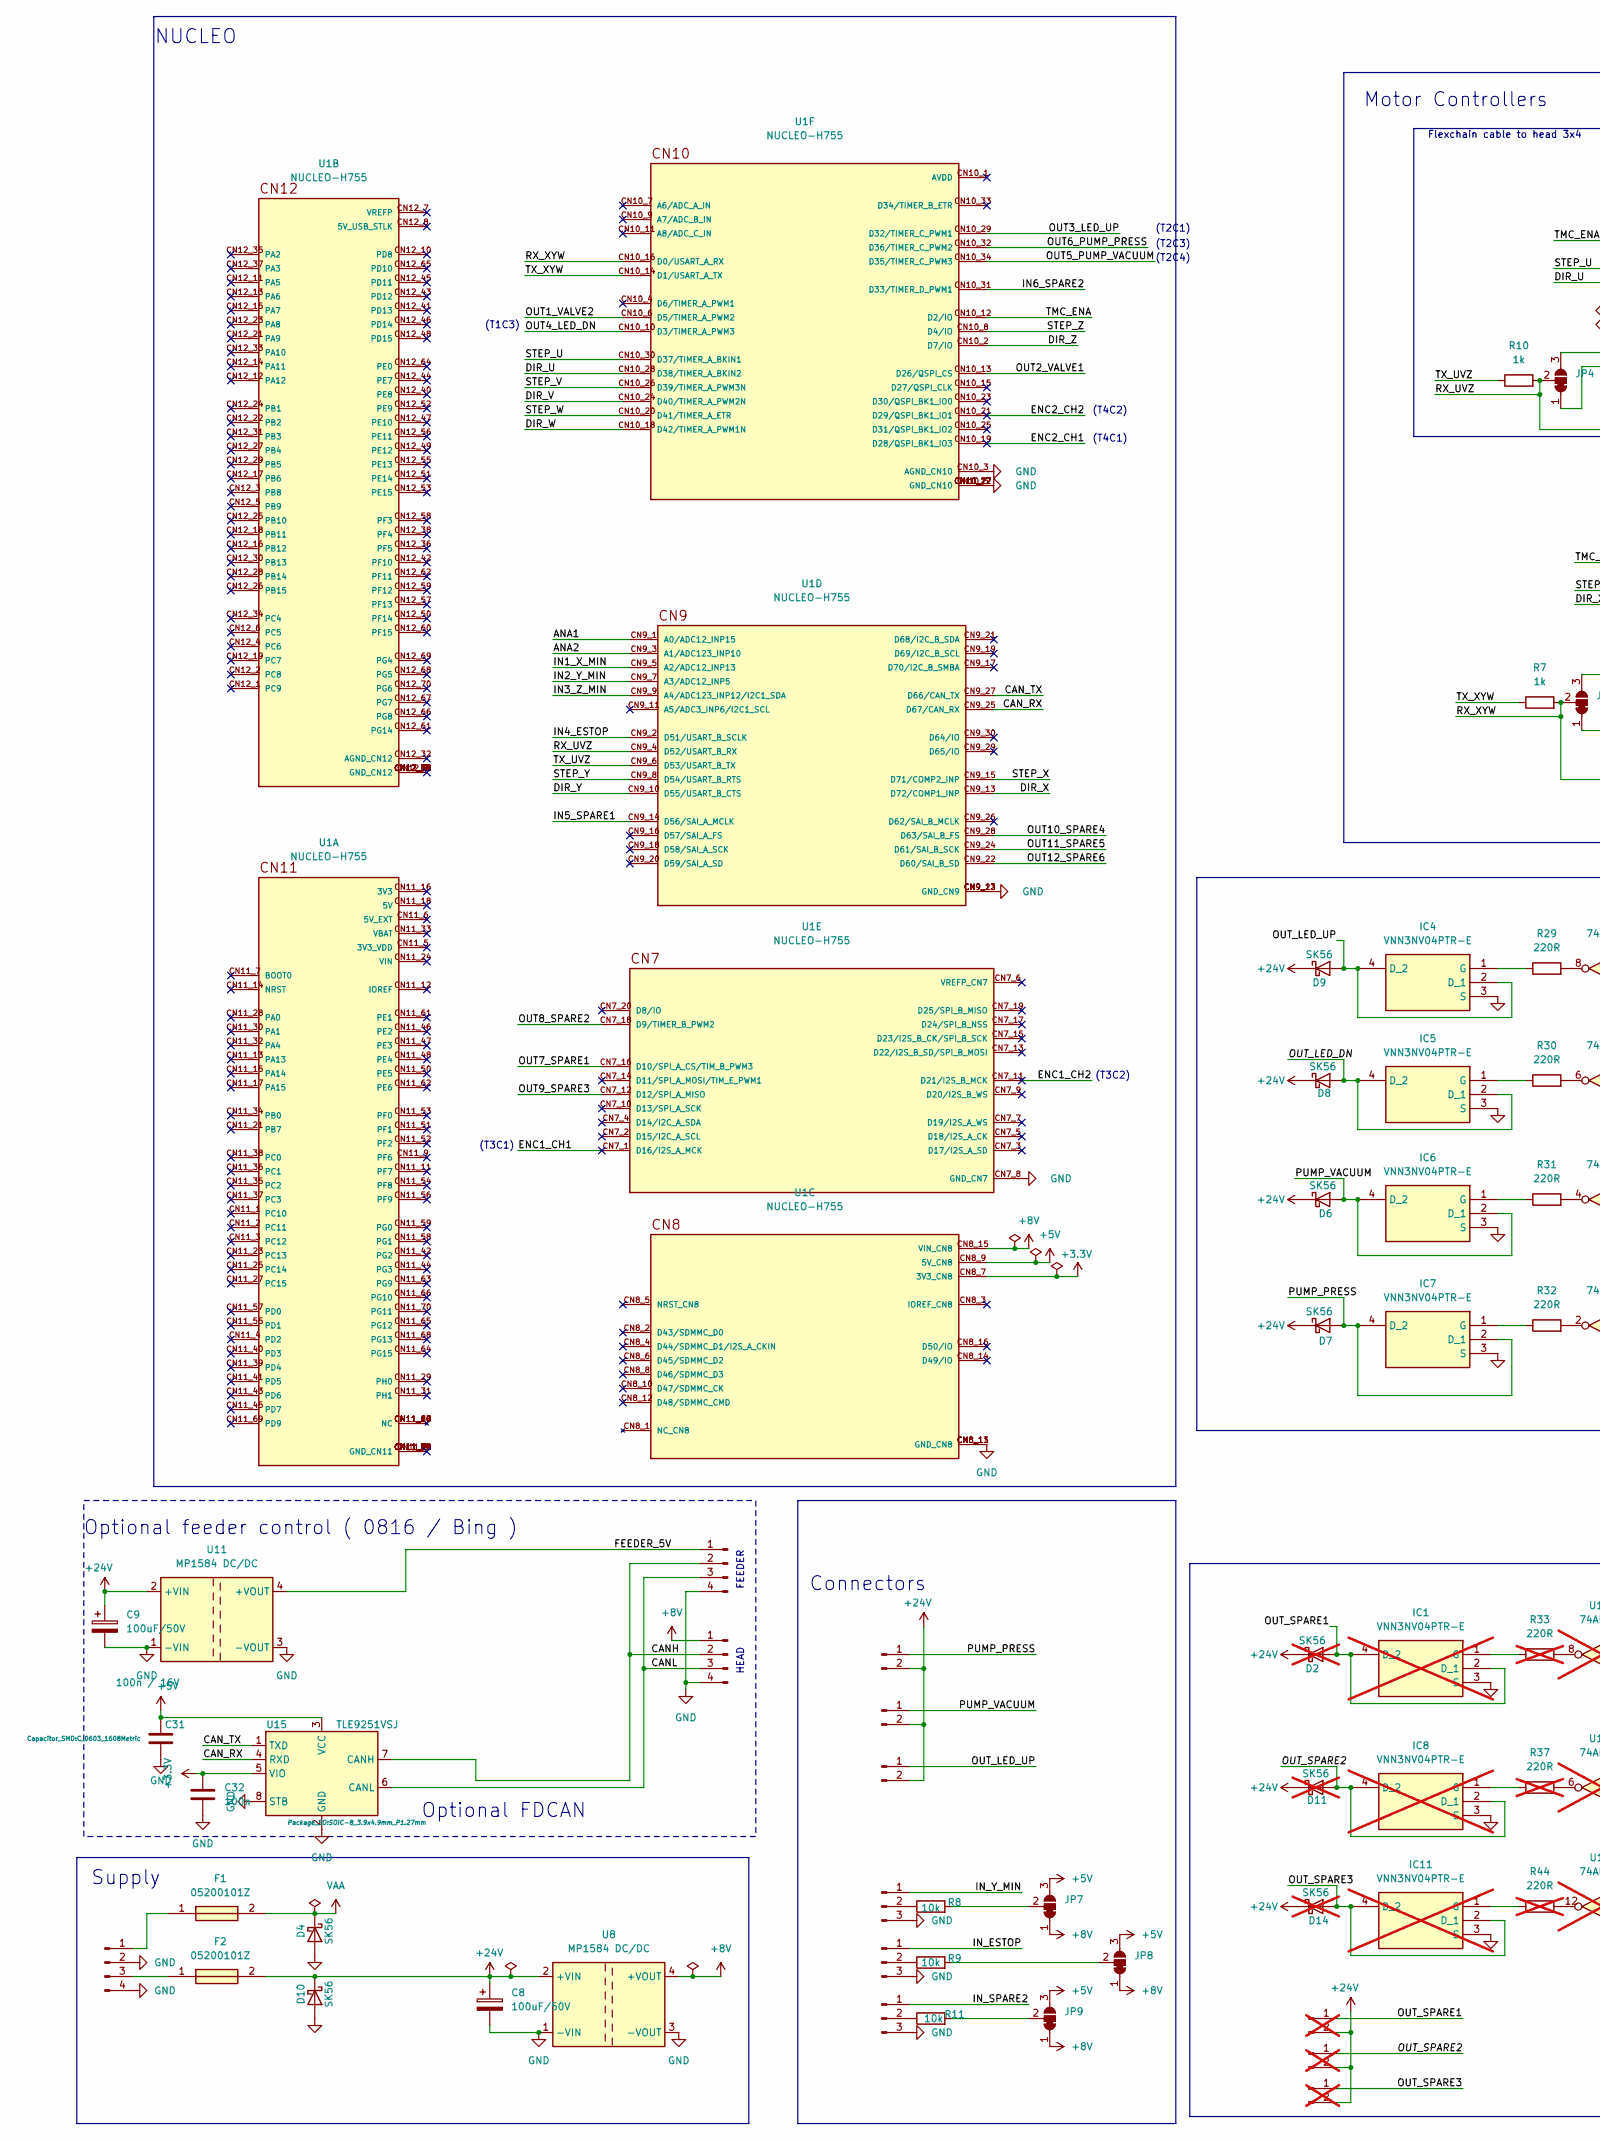
[picture p19: schematic UniMixBase.kicad_sch, part in row 1, column 1]

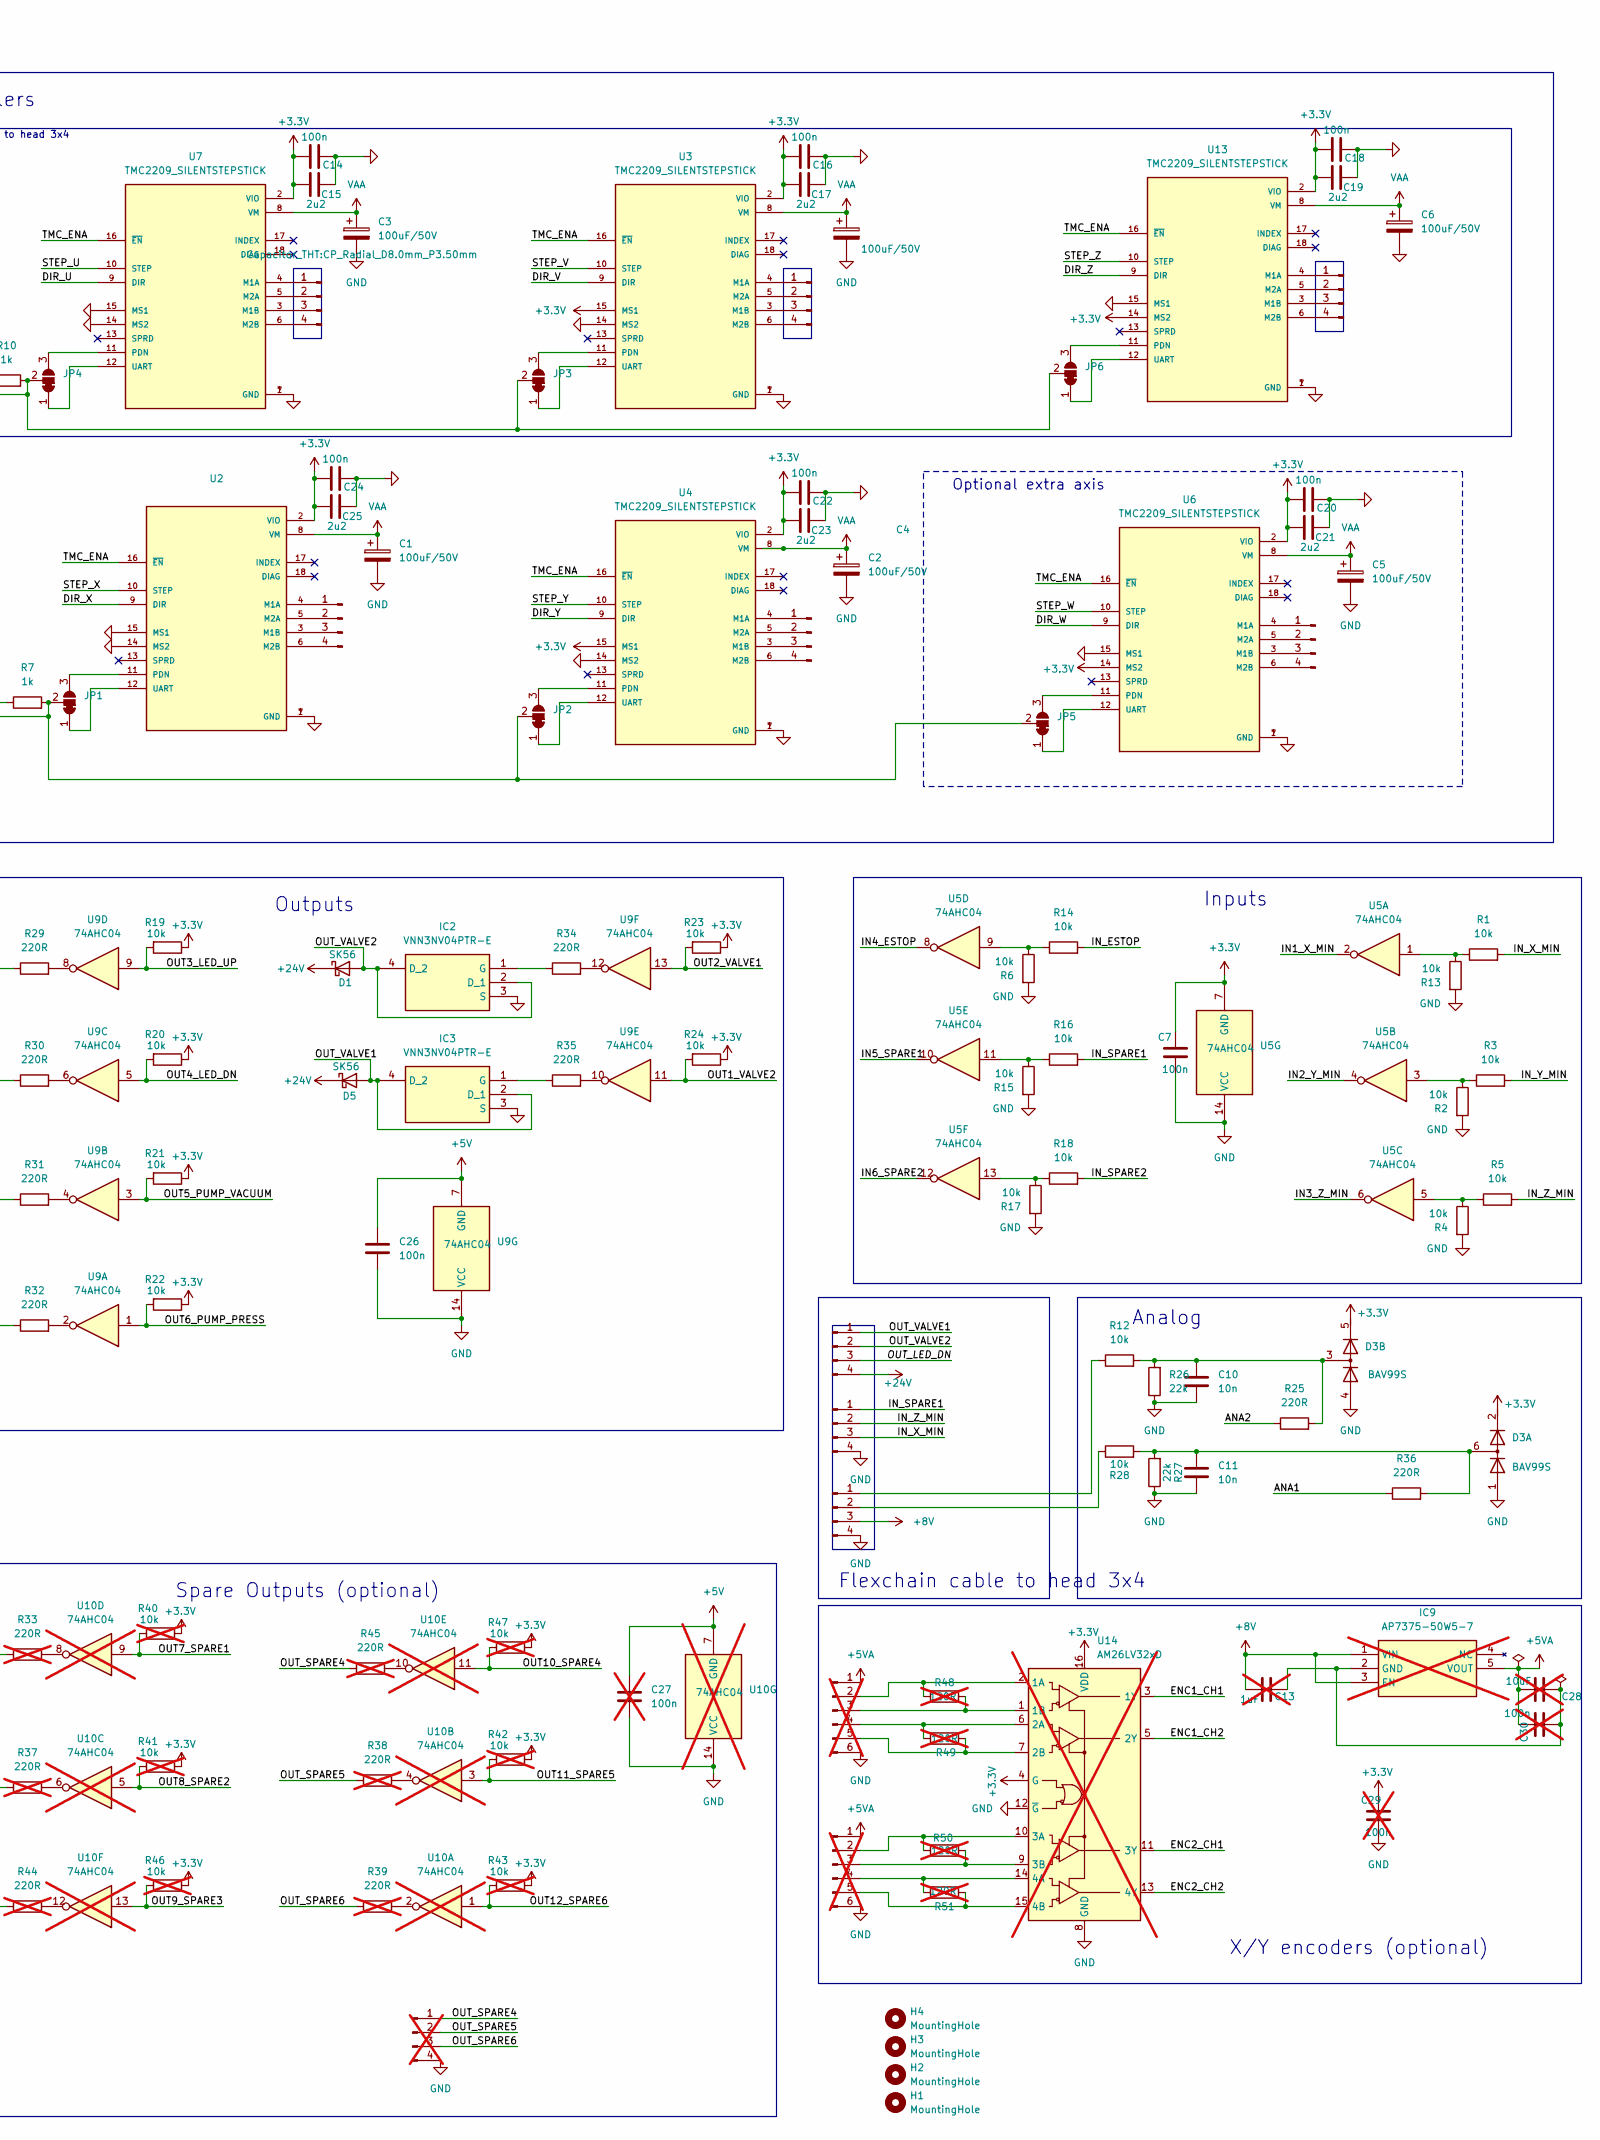
[picture p20: schematic UniMixBase.kicad_sch, part in row 1, column 2]

Parts:
C1, C2, C3, C4, C5, C6, C8, C9: 100uF/50V; CP_Radial_D8.0mm_P3.50mm
C7, C14, C16, C18, C20, C22, C24, C26, C32: 100n; C_0603_1608Metric
C10, C11: 10n; C_0603_1608Metric
C13: 1uF; C_0603_1608Metric; not fitted
C15, C17, C19, C21, C23, C25: 2u2; C_0603_1608Metric
C27, C29, C30: 100n; C_0603_1608Metric; not fitted
C28: 10uF; C_1206_3216Metric; not fitted
C31: 100n / 16V; C_0603_1608Metric; Digikey CC0402KRX7R7BB104
D1, D4, D5, D6, D7, D8, D9, D10: SK56; D_SMB
D2, D11, D14: SK56; D_SMB; not fitted
D3: BAV99S; SOT-363_SC-70-6
F1, F2: 05200101Z
H1, H2, H3, H4: MountingHole; MountingHole_3.2mm_M3
IC1, IC8, IC11: VNN3NV04PTR-E; SOT230P700X180-4N; Manufacturer_Part_Number VNN3NV04PTR-E; Mouser Part Number 511-VNN3NV04PTR-E; not fitted
IC2, IC3, IC4, IC5, IC6, IC7: VNN3NV04PTR-E; SOT230P700X180-4N; Manufacturer_Part_Number VNN3NV04PTR-E; Mouser Part Number 511-VNN3NV04PTR-E
IC9: AP7375-50W5-7; SOT95P285X140-5N; Manufacturer_Part_Number AP7375-50W5-7; Mouser Part Number 621-AP7375-50W5-7; not fitted
J1, J2, J3, J4, J5, J7, J8, J9, J18, J20, J21: Conn_01x04_Male; JST_XH_B4B-XH-AM_1x04_P2.50mm_Vertical
J6, J10, J22: Conn_01x03_Pin; JST_XH_B3B-XH-A_1x03_P2.50mm_Vertical
J11, J12, J13: Conn_01x02_Male; JST_XH_B2B-XH-A_1x02_P2.50mm_Vertical; not fitted
J14: Conn_01x04_Male; JST_XH_B4B-XH-AM_1x04_P2.50mm_Vertical; not fitted
J15, J16: Conn_01x06_Male; JST_XH_B6B-XH-AM_1x06_P2.50mm_Vertical; not fitted
J24: Conn_01x04_Male; TerminalBlock_Phoenix_MKDS-1,5-4-5.08_1x04_P5.08mm_Horizont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
J31, J32, J33: Conn_01x02_Male; JST_XH_B2B-XH-A_1x02_P2.50mm_Vertical
JP1, JP2, JP3, JP4, JP5, JP6, JP7, JP8, JP9: SolderJumper_3_Bridged12; SolderJumper-3_P1.3mm_Bridged12_RoundedPad1.0x1.5mm
R1, R2, R3, R4, R5, R6, R8, R9, R11, R12, R13, R14, R15, R16, R17, R18, R19, R20, R21, R22, R23, R24, R28: 10k; R_0603_1608Metric
R7, R10: 1k; R_0603_1608Metric
R25, R29, R30, R31, R32, R34, R35, R36: 220R; R_0603_1608Metric
R26, R27: 22k; R_0603_1608Metric
R33, R37, R38, R39, R44, R45: 220R; R_0603_1608Metric; not fitted
R40, R41, R42, R43, R46, R47: 10k; R_0603_1608Metric; not fitted
R48, R49, R50, R51: 120R; R_1206_3216Metric; not fitted
U1: NUCLEO-H755; MODULE_NUCLEO-H753ZI; PARTREV Rev. 2
U2, U3, U4, U6, U7, U13: TMC2209_SILENTSTEPSTICK; MODULE_TMC2209_SILENTSTEPSTICK; PARTREV 1.20
U5, U9: 74AHC04; SOIC-14_3.9x8.7mm_P1.27mm
U8, U11: MP1584 DC/DC; MP1584_mod
U10: 74AHC04; SOIC-14_3.9x8.7mm_P1.27mm; not fitted
U14: AM26LV32xD; SOIC-16_3.9x9.9mm_P1.27mm; not fitted
U15: TLE9251VSJ; SOIC-8_3.9x4.9mm_P1.27mm; Digikey TLE9251VSJXUMA1TR-ND

Connections:
+3.3V: C7.1, C14.2, C15.2, C16.2, C17.2, C18.2, C19.2, C20.2, C21.2, C22.2, C23.2, C24.2, C25.2, C29.1, C32.1, D3.2 (K2), D3.5 (K4), R19.1, R20.1, R21.1, R22.1, R23.1, R24.1, R40.1, R41.1, R42.1, R43.1, R46.1, R47.1, U1.CN8_7 (3V3_CN8), U2.2 (VIO), U3.2 (VIO), U3.15 (MS1), U4.2 (VIO), U4.15 (MS1), U5.7 (GND), U6.2 (VIO), U6.14 (MS2), U7.2 (VIO), U13.2 (VIO), U13.14 (MS2), U14.4 (G), U14.16 (VDD), U15.5 (VIO)
+5V: C26.1, C27.1, C31.1, JP7.3 (B), JP8.3 (B), JP9.3 (B), U1.CN8_9 (5V_CN8), U9.7 (GND), U10.7 (GND), U15.3 (VCC)
+5VA: C28.1, C30.1, IC9.5 (VOUT), J15.1, J16.1
+8V: C13.1, IC9.1 (VIN), IC9.3 (EN), J8.1, J20.3, JP7.1 (A), JP8.1 (A), JP9.1 (A), U1.CN8_15 (VIN_CN8), U8.4 (+VOUT)
+24V: C8.1, C9.1, D1.1 (K), D2.1 (K), D5.1 (K), D6.1 (K), D7.1 (K), D8.1 (K), D9.1 (K), D10.1 (K), D11.1 (K), D14.1 (K), F2.2, J11.2, J12.2, J13.2, J18.4, J31.2, J32.2, J33.2, U8.2 (+VIN), U11.2 (+VIN)
/ANA1: R36.1, U1.CN9_1 (A0/ADC12_INP15)
/ANA2: R25.1, U1.CN9_3 (A1/ADC123_INP10)
/CANH: J5.2, J8.2, U15.7 (CANH)
/CANL: J5.3, J8.3, U15.6 (CANL)
/CAN_RX: U1.CN9_25 (D67/CAN_RX), U15.4 (RXD)
/CAN_TX: U1.CN9_27 (D66/CAN_TX), U15.1 (TXD)
/DIR_U: U1.CN10_28 (D38/TIMER_A_BKIN2), U7.9 (DIR)
/DIR_V: U1.CN10_24 (D40/TIMER_A_PWM2N), U3.9 (DIR)
/DIR_W: U1.CN10_18 (D42/TIMER_A_PWM1N), U6.9 (DIR)
/DIR_X: U1.CN9_13 (D72/COMP1_INP), U2.9 (DIR)
/DIR_Y: U1.CN9_10 (D55/USART_B_CTS), U4.9 (DIR)
/DIR_Z: U1.CN10_2 (D7/IO), U13.9 (DIR)
/ENC1_CH1: U1.CN7_1 (D16/I2S_A_MCK), U14.3 (1Y)
/ENC1_CH2: U1.CN7_11 (D21/I2S_B_MCK), U14.5 (2Y)
/ENC2_CH1: U1.CN10_19 (D28/QSPI_BK1_IO3), U14.11 (3Y)
/ENC2_CH2: U1.CN10_21 (D29/QSPI_BK1_IO1), U14.13 (4Y)
/FEEDER_5V: J5.1, U11.4 (+VOUT)
/IN1_X_MIN: U1.CN9_5 (A2/ADC12_INP13), U5.2
/IN2_Y_MIN: U1.CN9_7 (A3/ADC12_INP5), U5.4
/IN3_Z_MIN: U1.CN9_9 (A4/ADC123_INP12/I2C1_SDA), U5.6
/IN4_ESTOP: U1.CN9_2 (D51/USART_B_SCLK), U5.8
/IN5_SPARE1: U1.CN9_14 (D56/SAI_A_MCLK), U5.10
/IN6_SPARE2: U1.CN10_31 (D33/TIMER_D_PWM1), U5.12
/IN_ESTOP: J22.1, R14.2
/IN_SPARE1: J21.1, R16.2
/IN_SPARE2: J10.1, R18.2
/IN_X_MIN: J21.3, R1.2
/IN_Y_MIN: J6.1, R3.2
/IN_Z_MIN: J21.2, R5.2
/OUT1_VALVE2: R24.2, U1.CN10_6 (D5/TIMER_A_PWM2), U9.11
/OUT2_VALVE1: R23.2, U1.CN10_13 (D26/QSPI_CS), U9.13
/OUT3_LED_UP: R19.2, U1.CN10_29 (D32/TIMER_C_PWM1), U9.9
/OUT4_LED_DN: R20.2, U1.CN10_10 (D3/TIMER_A_PWM3), U9.5
/OUT5_PUMP_VACUUM: R21.2, U1.CN10_34 (D35/TIMER_C_PWM3), U9.3
/OUT6_PUMP_PRESS: R22.2, U1.CN10_32 (D36/TIMER_C_PWM2), U9.1
/OUT7_SPARE1: R40.2, U1.CN7_16 (D10/SPI_A_CS/TIM_B_PWM3), U10.9
/OUT8_SPARE2: R41.2, U1.CN7_18 (D9/TIMER_B_PWM2), U10.5
/OUT9_SPARE3: R46.2, U1.CN7_12 (D12/SPI_A_MISO), U10.13
/OUT10_SPARE4: R47.2, U1.CN9_28 (D63/SAI_B_FS), U10.11
/OUT11_SPARE5: R42.2, U1.CN9_24 (D61/SAI_B_SCK), U10.3
/OUT12_SPARE6: R43.2, U1.CN9_22 (D60/SAI_B_SD), U10.1
/OUT_LED_DN: D8.2 (A), IC5.2 (D_1), IC5.4 (D_2), J18.3
/OUT_LED_UP: D9.2 (A), IC4.2 (D_1), IC4.4 (D_2), J33.1
/OUT_SPARE1: D2.2 (A), IC1.2 (D_1), IC1.4 (D_2), J11.1
/OUT_SPARE2: D11.2 (A), IC8.2 (D_1), IC8.4 (D_2), J12.1
/OUT_SPARE3: D14.2 (A), IC11.2 (D_1), IC11.4 (D_2), J13.1
/OUT_SPARE4: J14.1, R45.1
/OUT_SPARE5: J14.2, R38.1
/OUT_SPARE6: J14.3, R39.1
/OUT_VALVE1: D5.2 (A), IC3.2 (D_1), IC3.4 (D_2), J18.1
/OUT_VALVE2: D1.2 (A), IC2.2 (D_1), IC2.4 (D_2), J18.2
/PUMP_PRESS: D7.2 (A), IC7.2 (D_1), IC7.4 (D_2), J32.1
/PUMP_VACUUM: D6.2 (A), IC6.2 (D_1), IC6.4 (D_2), J31.1
/RX_UVZ: JP3.2 (C), JP4.2 (C), JP6.2 (C), R10.2, U1.CN9_4 (D52/USART_B_RX)
/RX_XYW: JP1.2 (C), JP2.2 (C), JP5.2 (C), R7.2, U1.CN10_16 (D0/USART_A_RX)
/STEP_U: U1.CN10_30 (D37/TIMER_A_BKIN1), U7.10 (STEP)
/STEP_V: U1.CN10_26 (D39/TIMER_A_PWM3N), U3.10 (STEP)
/STEP_W: U1.CN10_20 (D41/TIMER_A_ETR), U6.10 (STEP)
/STEP_X: U1.CN9_15 (D71/COMP2_INP), U2.10 (STEP)
/STEP_Y: U1.CN9_8 (D54/USART_B_RTS), U4.10 (STEP)
/STEP_Z: U1.CN10_8 (D4/IO), U13.10 (STEP)
/TMC_ENA: U1.CN10_12 (D2/IO), U2.16 (~EN), U3.16 (~EN), U4.16 (~EN), U6.16 (~EN), U7.16 (~EN), U13.16 (~EN)
/TX_UVZ: R10.1, U1.CN9_6 (D53/USART_B_TX)
/TX_XYW: R7.1, U1.CN10_14 (D1/USART_A_TX)
GND: C1.2, C2.2, C3.2, C4.2, C5.2, C6.2, C7.2, C8.2, C9.2, C10.2, C11.2, C14.1, C15.1, C16.1, C17.1, C18.1, C19.1, C20.1, C21.1, C22.1, C23.1, C24.1, C25.1, C26.2, C27.2, C29.2, C31.2, C32.2, D3.1 (A1), D3.4 (A3), D4.2 (A), D10.2 (A), IC1.3 (S), IC2.3 (S), IC3.3 (S), IC4.3 (S), IC5.3 (S), IC6.3 (S), IC7.3 (S), IC8.3 (S), IC11.3 (S), J5.4, J6.3, J8.4, J10.3, J14.4, J15.6, J16.6, J20.4, J21.4, J22.3, J24.2, J24.4, R2.2, R4.2, R6.2, R13.2, R15.2, R17.2, R26.1, R27.1, U1.CN7_8 (GND_CN7), U1.CN8_11 (GND_CN8), U1.CN8_13 (GND_CN8), U1.CN9_12 (GND_CN9), U1.CN9_23 (GND_CN9), U1.CN10_3 (AGND_CN10), U1.CN10_5 (GND_CN10), U1.CN10_17 (GND_CN10), U1.CN10_22 (GND_CN10), U1.CN10_27 (GND_CN10), U2.1 (GND), U2.7 (GND), U2.14 (MS2), U2.15 (MS1), U3.1 (GND), U3.7 (GND), U3.14 (MS2), U4.1 (GND), U4.7 (GND), U4.14 (MS2), U5.14 (VCC), U6.1 (GND), U6.7 (GND), U6.15 (MS1), U7.1 (GND), U7.7 (GND), U7.14 (MS2), U7.15 (MS1), U8.1 (-VIN), U8.3 (-VOUT), U9.14 (VCC), U10.14 (VCC), U11.1 (-VIN), U11.3 (-VOUT), U13.1 (GND), U13.7 (GND), U13.15 (MS1), U14.8 (GND), U14.12 (~G), U15.2 (GND), U15.8 (STB)
unnamed: C11.1, D3.6 (K3A4), R27.2, R28.2, R36.2
unnamed: C10.1, D3.3 (K1A2), R12.2, R25.2, R26.2
unnamed: IC1.1 (G), R33.1
unnamed: IC2.1 (G), R34.1
unnamed: IC3.1 (G), R35.1
unnamed: IC4.1 (G), R29.1
unnamed: IC5.1 (G), R30.1
unnamed: IC6.1 (G), R31.1
unnamed: IC7.1 (G), R32.1
unnamed: IC8.1 (G), R37.1
unnamed: C13.2, C28.2, C30.2, IC9.2 (GND)
unnamed: IC11.1 (G), R44.1
unnamed: J1.1, U3.4 (M1A)
unnamed: J1.2, U3.5 (M2A)
unnamed: J1.3, U3.3 (M1B)
unnamed: J1.4, U3.6 (M2B)
unnamed: J2.1, U4.4 (M1A)
unnamed: J2.2, U4.5 (M2A)
unnamed: J2.3, U4.3 (M1B)
unnamed: J2.4, U4.6 (M2B)
unnamed: J3.1, U13.4 (M1A)
unnamed: J3.2, U13.5 (M2A)
unnamed: J3.3, U13.3 (M1B)
unnamed: J3.4, U13.6 (M2B)
unnamed: J4.1, U7.4 (M1A)
unnamed: J4.2, U7.5 (M2A)
unnamed: J4.3, U7.3 (M1B)
unnamed: J4.4, U7.6 (M2B)
unnamed: J6.2, R8.1
unnamed: J7.1, U2.4 (M1A)
unnamed: J7.2, U2.5 (M2A)
unnamed: J7.3, U2.3 (M1B)
unnamed: J7.4, U2.6 (M2B)
unnamed: J9.1, U6.4 (M1A)
unnamed: J9.2, U6.5 (M2A)
unnamed: J9.3, U6.3 (M1B)
unnamed: J9.4, U6.6 (M2B)
unnamed: J10.2, R11.1
unnamed: J15.2, R48.1, U14.2 (1A)
unnamed: J15.3, R48.2, U14.1 (1B)
unnamed: J15.4, R49.1, U14.6 (2A)
unnamed: J15.5, R49.2, U14.7 (2B)
unnamed: J16.2, R50.1, U14.10 (3A)
unnamed: J16.3, R50.2, U14.9 (3B)
unnamed: J16.4, R51.1, U14.14 (4A)
unnamed: J16.5, R51.2, U14.15 (4B)
unnamed: J20.1, R12.1
unnamed: J20.2, R28.1
unnamed: J22.2, R9.1
unnamed: F1.1, J24.1
unnamed: F2.1, J24.3
unnamed: JP1.1 (A), U2.12 (UART)
unnamed: JP1.3 (B), U2.11 (PDN)
unnamed: JP2.1 (A), U4.12 (UART)
unnamed: JP2.3 (B), U4.11 (PDN)
unnamed: JP3.1 (A), U3.12 (UART)
unnamed: JP3.3 (B), U3.11 (PDN)
unnamed: JP4.1 (A), U7.12 (UART)
unnamed: JP4.3 (B), U7.11 (PDN)
unnamed: JP5.1 (A), U6.12 (UART)
unnamed: JP5.3 (B), U6.11 (PDN)
unnamed: JP6.1 (A), U13.12 (UART)
unnamed: JP6.3 (B), U13.11 (PDN)
unnamed: JP7.2 (C), R8.2
unnamed: JP8.2 (C), R9.2
unnamed: JP9.2 (C), R11.2
unnamed: R1.1, R13.1, U5.1
unnamed: R2.1, R3.1, U5.3
unnamed: R4.1, R5.1, U5.5
unnamed: R6.1, R14.1, U5.9
unnamed: R15.1, R16.1, U5.11
unnamed: R17.1, R18.1, U5.13
unnamed: R29.2, U9.8
unnamed: R30.2, U9.6
unnamed: R31.2, U9.4
unnamed: R32.2, U9.2
unnamed: R33.2, U10.8
unnamed: R34.2, U9.12
unnamed: R35.2, U9.10
unnamed: R37.2, U10.6
unnamed: R38.2, U10.4
unnamed: R39.2, U10.2
unnamed: R44.2, U10.12
unnamed: R45.2, U10.10
VAA: C1.1, C2.1, C3.1, C4.1, C5.1, C6.1, D4.1 (K), F1.2, U2.8 (VM), U3.8 (VM), U4.8 (VM), U6.8 (VM), U7.8 (VM), U13.8 (VM)

Notes on the sheet:
Optional extra axis
(T1C3)
FEEDER
Motor Controllers
(T4C2)
(T3C2)
Optional FDCAN
(T2C4)
Analog
Optional feeder control ( 0816 / Bing )
Inputs
HEAD
NUCLEO
(T2C3)
Outputs
Flexchain cable to head 3x4
Supply
Connectors
X/Y encoders (optional)
(T3C1)
(T4C1)
(T2C1)
Spare Outputs (optional)

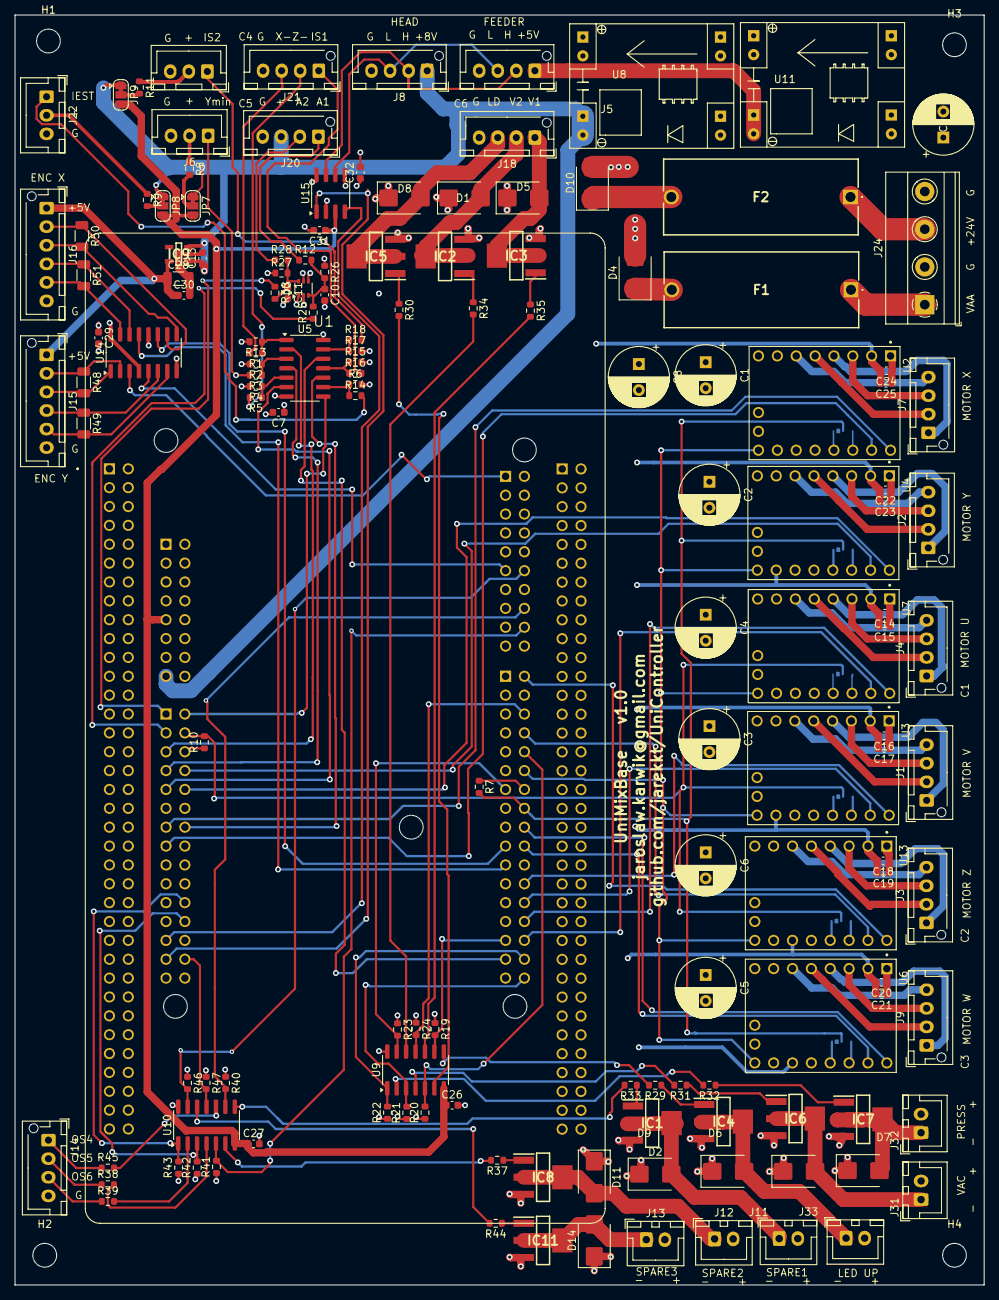
[picture p21: board UniMixBase.kicad_pcb from above]

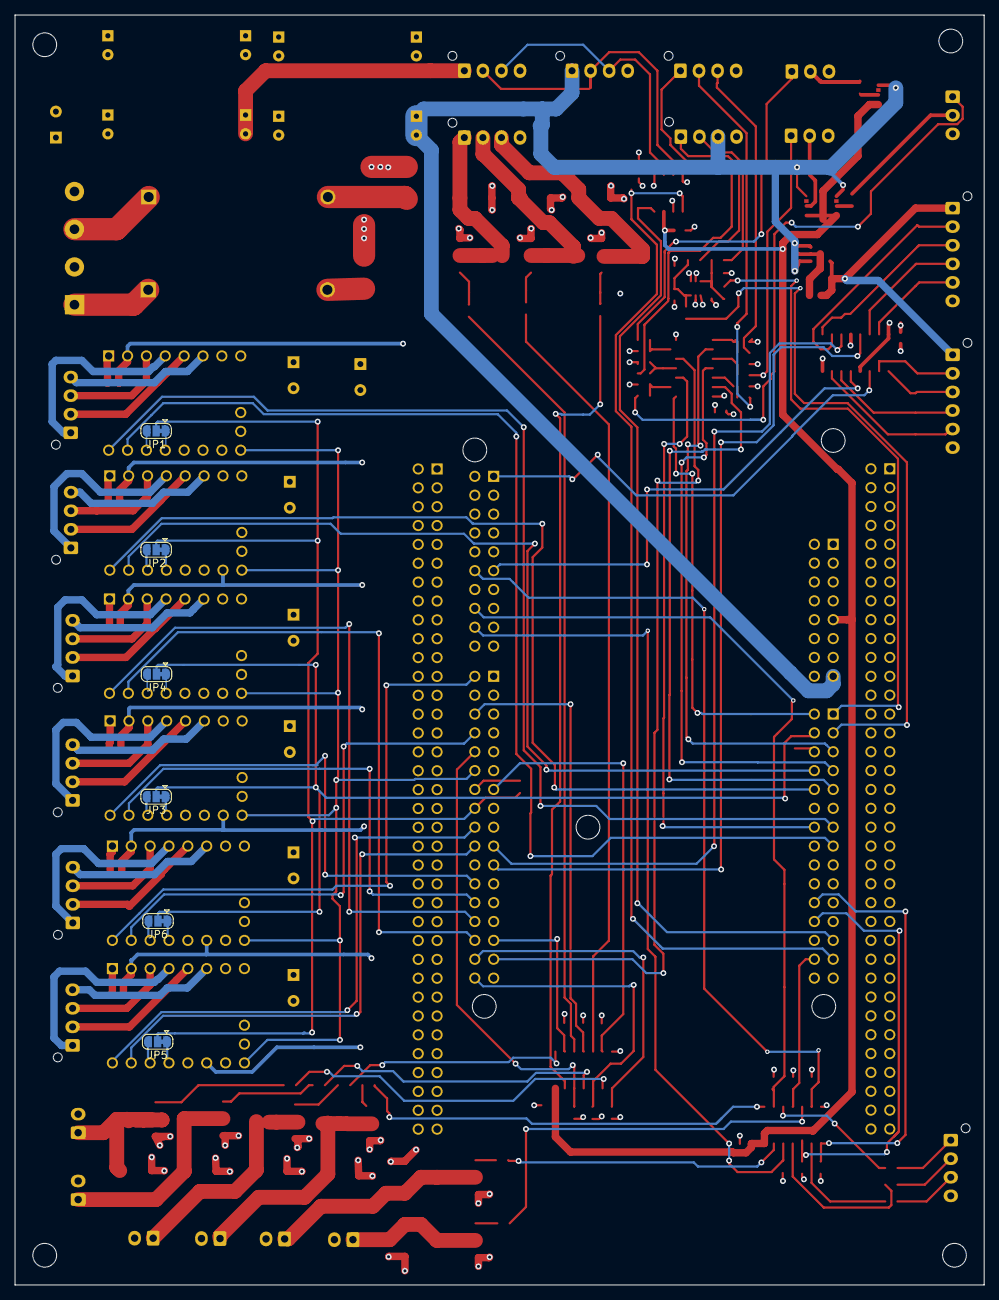
[picture p22: board UniMixBase.kicad_pcb from below]

Board: 4 copper layers, 130.5 x 171.0 mm, 157 parts (6 on the bottom side), 155 nets.
