jarekkt/UniController/hardware/12_mixture/UniMixHead/UniMixHead.kicad_pcb

## KiCad design hardware/12_mixture/UniMixHead/UniMixHead.kicad_pcb (2025-02-07)

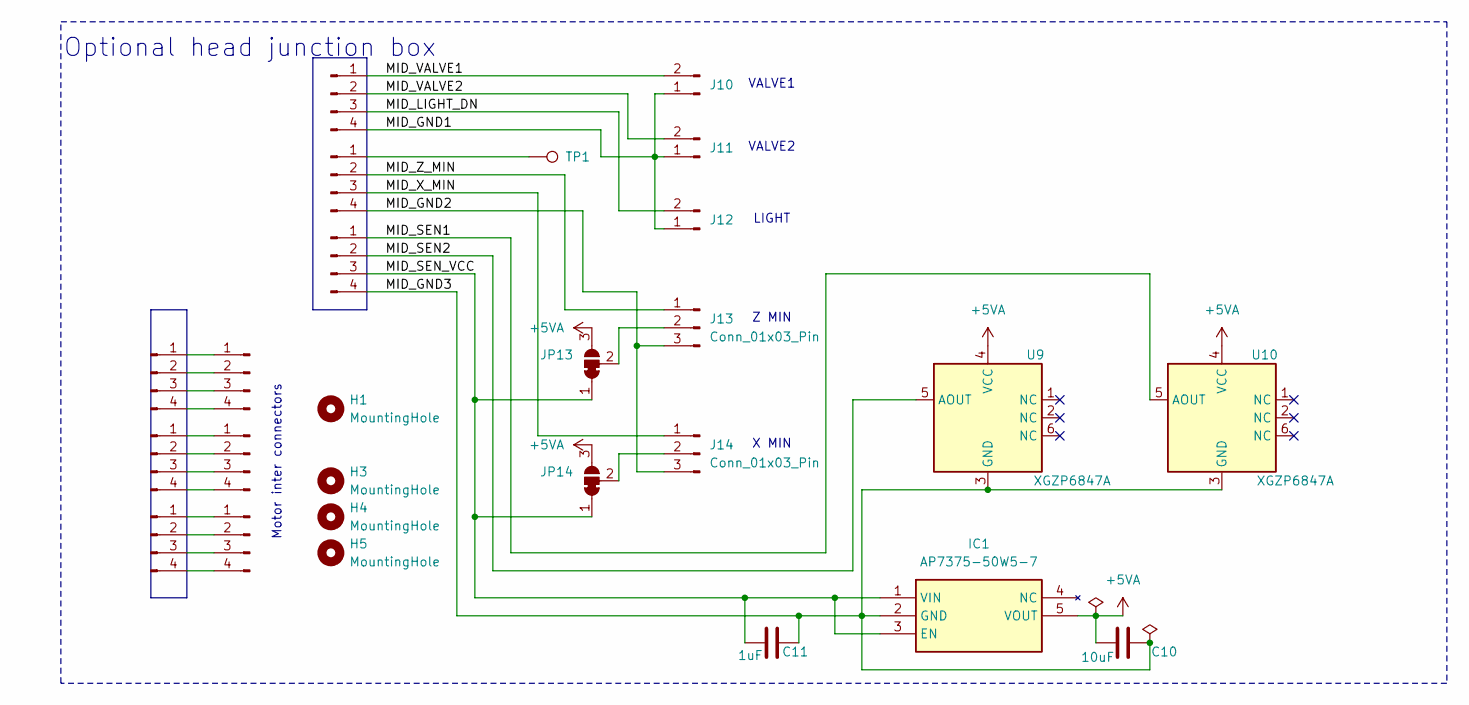
[picture p23: schematic UniMixHead.kicad_sch]

Parts:
C10: 10uF; C_1206_3216Metric
C11: 1uF; C_0603_1608Metric
H1, H3, H4, H5: MountingHole; MountingHole_3.2mm_M3
IC1: AP7375-50W5-7; SOT95P285X140-5N; Manufacturer_Part_Number AP7375-50W5-7; Mouser Part Number 621-AP7375-50W5-7
J10, J11, J12: Conn_01x02_Male; JST_XH_B2B-XH-A_1x02_P2.50mm_Vertical
J13, J14: Conn_01x03_Pin; JST_XH_B3B-XH-A_1x03_P2.50mm_Vertical
J16, J17, J19, J25, J26, J27, J28, J29, J30: Conn_01x04_Male; JST_XH_B4B-XH-AM_1x04_P2.50mm_Vertical
JP13, JP14: SolderJumper_3_Bridged12; SolderJumper-3_P1.3mm_Bridged12_RoundedPad1.0x1.5mm
TP1: TestPoint; PinHeader_1x01_P1.00mm_Vertical
U9, U10: XGZP6847A; DIP-6_W10.16mm

Connections:
+5VA: C10.1, IC1.5 (VOUT), JP13.3 (B), JP14.3 (B), U9.4 (VCC), U10.4 (VCC)
/MID_GND1: J10.1, J11.1, J12.1, J16.4
/MID_GND2: J13.3, J14.3, J19.4
/MID_GND3: C10.2, C11.2, IC1.2 (GND), J17.4, U9.3 (GND), U10.3 (GND)
/MID_LIGHT_DN: J12.2, J16.3
/MID_SEN1: J17.1, U10.5 (AOUT)
/MID_SEN2: J17.2, U9.5 (AOUT)
/MID_SEN_VCC: C11.1, IC1.1 (VIN), IC1.3 (EN), J17.3, JP13.1 (A), JP14.1 (A)
/MID_VALVE1: J10.2, J16.1
/MID_VALVE2: J11.2, J16.2
/MID_X_MIN: J14.1, J19.3
/MID_Z_MIN: J13.1, J19.2
unnamed: J13.2, JP13.2 (C)
unnamed: J14.2, JP14.2 (C)
unnamed: J19.1, TP1.1
unnamed: J25.1, J28.1
unnamed: J25.2, J28.2
unnamed: J25.3, J28.3
unnamed: J25.4, J28.4
unnamed: J26.1, J29.1
unnamed: J26.2, J29.2
unnamed: J26.3, J29.3
unnamed: J26.4, J29.4
unnamed: J27.1, J30.1
unnamed: J27.2, J30.2
unnamed: J27.3, J30.3
unnamed: J27.4, J30.4

Notes on the sheet:
Z MIN
LIGHT
VALVE1
X MIN
VALVE2
Motor inter connectors
Optional head junction box

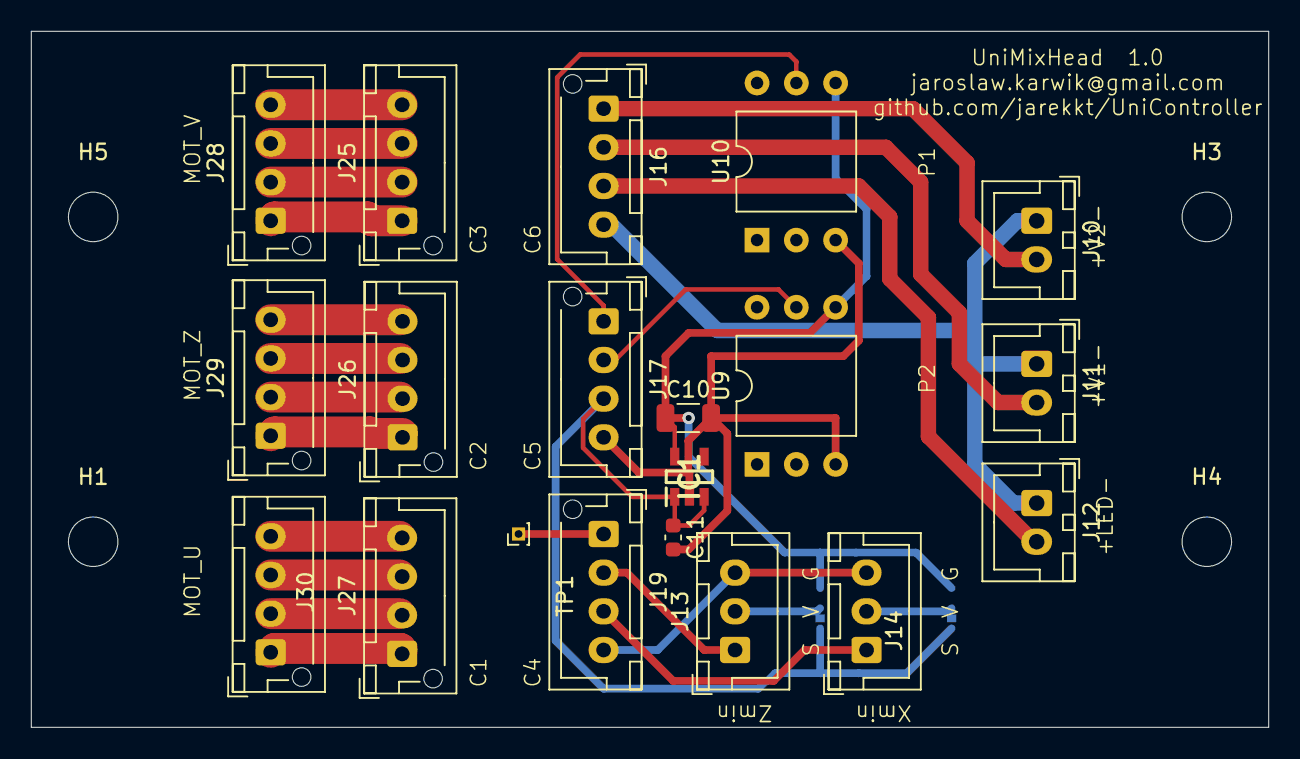
[picture p24: board UniMixHead.kicad_pcb from above]

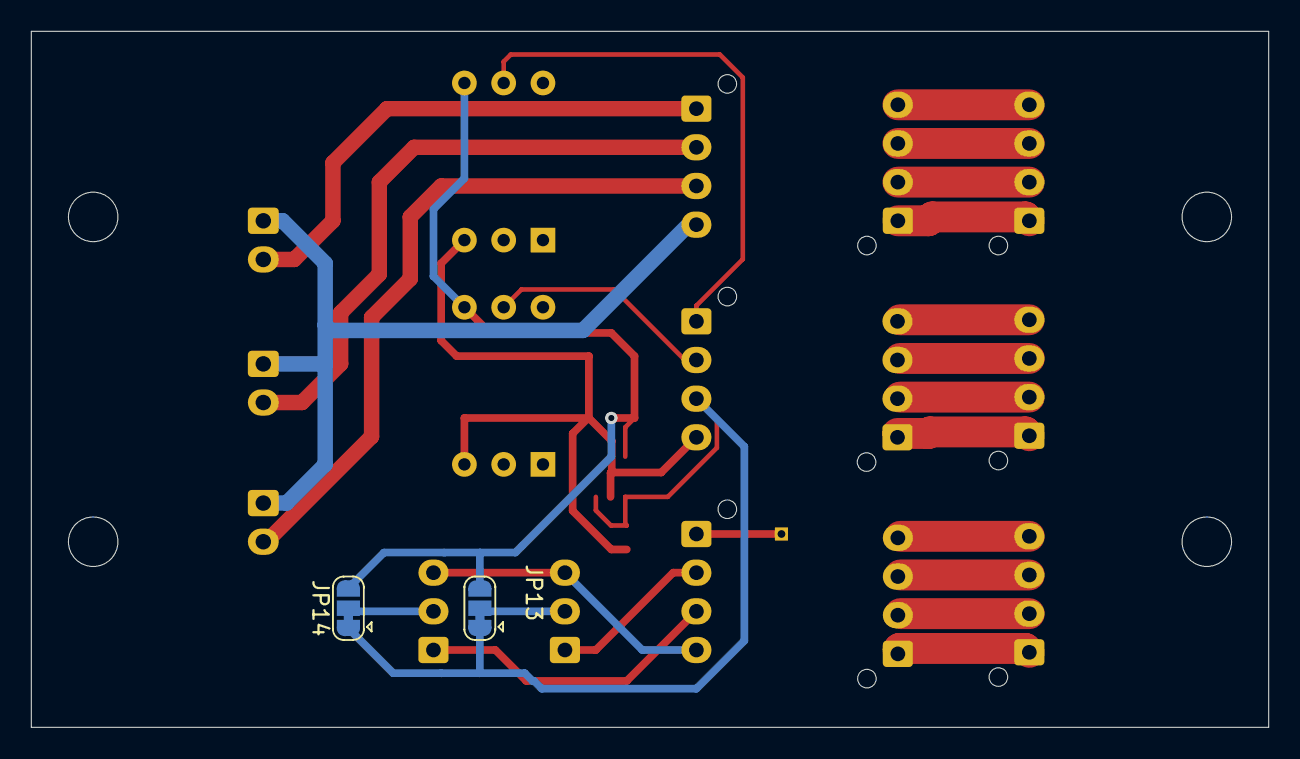
[picture p25: board UniMixHead.kicad_pcb from below]

Board: 2 copper layers, 80.0 x 45.0 mm, 26 parts (2 on the bottom side), 27 nets.
