jarekkt/UniController/software/00_controller/lib_code/services/gpio/srv_gpio.c

#include "system.h"
#include "services.h"
#include "engine.h"
#include "gpio_srv.h"


volatile int32_t gpio_test_mode = 0;


typedef struct
{
	uint32_t 		out[PWM_GLOBAL_CNT];
	uint32_t		timer[PWM_GLOBAL_CNT];

	uint32_t		update_req[PWM_GLOBAL_CNT];
	uint32_t		update_val[PWM_GLOBAL_CNT];

	uint32_t		value;
	uint32_t		value_prev;
	uint32_t		force_update;
}gpio_pwm_type;

gpio_pwm_type	gpio_pwm;




void      srv_gpio_init(void)
{
	memset(&gpio_pwm,0,sizeof(gpio_pwm));
}



uint32_t  srv_gpio_get_io(void)
{
	uint32_t  io = 0;

	if(GPIO_Get(IN_CPU1)!=0)
	{
		io |= BV(0);
	}

	if(GPIO_Get(IN_CPU2)!=0)
	{
		io |= BV(1);
	}

	if(GPIO_Get(IN_CPU3)!=0)
	{
		io |= BV(2);
	}

	if(GPIO_Get(IN_CPU4)!=0)
	{
		io |= BV(3);
	}

	if(GPIO_Get(IN_CPU5)!=0)
	{
		io |= BV(4);
	}

	if(GPIO_Get(IN_CPU6)!=0)
	{
		io |= BV(5);
	}

	if(GPIO_Get(IN_CPU7)!=0)
	{
		io |= BV(6);
	}

	if(GPIO_Get(IN_CPU8)!=0)
	{
		io |= BV(7);
	}

	if(GPIO_Get(IN_CPU9)!=0)
	{
		io |= BV(8);
	}

	if(GPIO_Get(IN_CPU10)!=0)
	{
		io |= BV(9);
	}

	if(GPIO_Get(IO_CPU1)!=0)
	{
		io |= BV(0+16);
	}

	if(GPIO_Get(IO_CPU2)!=0)
	{
		io |= BV(1+16);
	}

	if(GPIO_Get(IO_CPU3)!=0)
	{
		io |= BV(2+16);
	}

	if(GPIO_Get(IO_CPU4)!=0)
	{
		io |= BV(3+16);
	}

	if(GPIO_Get(IO_CPU5)!=0)
	{
		io |= BV(4+16);
	}

	if(GPIO_Get(IO_CPU6)!=0)
	{
		io |= BV(5+16);
	}

	if(GPIO_Get(IO_CPU7)!=0)
	{
		io |= BV(6+16);
	}

	if(GPIO_Get(IO_CPU8)!=0)
	{
		io |= BV(7+16);
	}

	if(GPIO_Get(IO_CPU9)!=0)
	{
		io |= BV(8+16);
	}


	return io;
}


void      srv_gpio_set_pwm(pwm_idx_e id,uint32_t enable)
{
	if(enable != 0)
	{
		gpio_pwm.timer[id]  = ppctx_nv->pwm_range[id].delay_ms;

		if(gpio_pwm.timer[id] == 0)
		{
			srv_timer_pwm(id,ppctx_nv->pwm_range[id].max);
		}
		else
		{
			srv_timer_pwm(id,100);
		}

		gpio_pwm.out [id]  = 1;
	}
	else
	{
		gpio_pwm.timer[id] = 0;
		gpio_pwm.out[id] 	 = 0;

		srv_timer_pwm(id,ppctx_nv->pwm_range[id].min);
	}
}



void      srv_gpio_tick_io(void)
{
	pwm_idx_e ii;


	// Global parameter change, make sure we are up to date
	if(	gpio_pwm.force_update != 0)
	{
		gpio_pwm.force_update = 0;

		for(ii = 0; ii < PWM_GLOBAL_CNT;ii++)
		{
			if(gpio_pwm.out[ii] != 0 )
			{
				if( gpio_pwm.timer[ii] == 0)
				{
					srv_timer_pwm(ii,ppctx_nv->pwm_range[ii].max);
				}
				else
				{
					// 100% case , no need to update
				}
			}
			else
			{
				srv_timer_pwm(ii,ppctx_nv->pwm_range[ii].min);
			}
		}
	}


	// Process updates and timers
	for(ii = 0; ii < PWM_GLOBAL_CNT;ii++)
	{
		if(gpio_pwm.update_req[ii] != 0)
		{
			srv_gpio_set_pwm(ii,gpio_pwm.update_val[ii]);
			gpio_pwm.update_req[ii] = 0;
		}

		if(gpio_pwm.out[ii] != 0 )
		{
			if( gpio_pwm.timer[ii] > 0)
			{
				gpio_pwm.timer[ii]--;
				if(gpio_pwm.timer[ii] == 0)
				{
					srv_timer_pwm(ii,ppctx_nv->pwm_range[ii].max);
				}
			}
		}
	}
}


void      srv_gpio_set_io(uint32_t mask,uint32_t value)
{

	if(mask & BV(0))
	{
		gpio_pwm.update_req[PWM_OUT1] = 1;
		gpio_pwm.update_val[PWM_OUT1] = value & BV(0);
	}

	if(mask & BV(1))
	{
		gpio_pwm.update_req[PWM_OUT2] = 1;
		gpio_pwm.update_val[PWM_OUT2] = value & BV(1);
	}

	if(mask & BV(2))
	{
		gpio_pwm.update_req[PWM_OUT3] = 1;
		gpio_pwm.update_val[PWM_OUT3] = value & BV(2);
	}

	if(mask & BV(3))
	{
		gpio_pwm.update_req[PWM_OUT4] = 1;
		gpio_pwm.update_val[PWM_OUT4] = value & BV(3);
	}

	if(mask & BV(4))
	{
		if(value & BV(4))
		{
			GPIO_Set(OUT_CPU5);
		}
		else
		{
			GPIO_Clr(OUT_CPU5);
		}
	}

	if(mask & BV(5))
	{
		if(value & BV(5))
		{
			GPIO_Set(OUT_CPU6);
		}
		else
		{
			GPIO_Clr(OUT_CPU6);
		}
	}

	if(mask & BV(6))
	{
		if(value & BV(6))
		{
			GPIO_Set(OUT_CPU7);
		}
		else
		{
			GPIO_Clr(OUT_CPU7);
		}
	}
	if(mask & BV(7))
	{
		if(value & BV(7))
		{
			GPIO_Set(OUT_CPU8);
		}
		else
		{
			GPIO_Clr(OUT_CPU8);
		}
	}

	if(mask & BV(8))
	{
		if(value & BV(8))
		{
			GPIO_Set(OUT_CPU9);
		}
		else
		{
			GPIO_Clr(OUT_CPU9);
		}
	}

	if(mask & BV(9))
	{
		if(value & BV(9))
		{
			GPIO_Set(OUT_CPU10);
		}
		else
		{
			GPIO_Clr(OUT_CPU10);
		}
	}


	if(mask & BV(10))
	{
		gpio_pwm.update_req[PWM_OUT11] = 1;
		gpio_pwm.update_val[PWM_OUT11] = value & BV(10);
	}



	if(mask & BV(11))
	{
		gpio_pwm.update_req[PWM_OUT12] = 1;
		gpio_pwm.update_val[PWM_OUT12] = value & BV(11);
	}


	if(mask & BV(0+16))
	{
		if(value & BV(0+16))
		{
			GPIO_Set(IO_CPU1);
		}
		else
		{
			GPIO_Clr(IO_CPU1);
		}
	}


	if(mask & BV(1+16))
	{
		if(value & BV(1+16))
		{
			GPIO_Set(IO_CPU2);
		}
		else
		{
			GPIO_Clr(IO_CPU2);
		}
	}

	if(mask & BV(2+16))
	{
		if(value & BV(2+16))
		{
			GPIO_Set(IO_CPU3);
		}
		else
		{
			GPIO_Clr(IO_CPU3);
		}
	}

	if(mask & BV(3+16))
	{
		if(value & BV(3+16))
		{
			GPIO_Set(IO_CPU4);
		}
		else
		{
			GPIO_Clr(IO_CPU4);
		}
	}

	if(mask & BV(4+16))
	{
		if(value & BV(4+16))
		{
			GPIO_Set(IO_CPU5);
		}
		else
		{
			GPIO_Clr(IO_CPU5);
		}
	}

	if(mask & BV(5+16))
	{
		if(value & BV(5+16))
		{
			GPIO_Set(IO_CPU6);
		}
		else
		{
			GPIO_Clr(IO_CPU6);
		}
	}

	if(mask & BV(6+16))
	{
		if(value & BV(6+16))
		{
			GPIO_Set(IO_CPU7);
		}
		else
		{
			GPIO_Clr(IO_CPU7);
		}
	}

	if(mask & BV(7+16))
	{
		if(value & BV(7+16))
		{
			GPIO_Set(IO_CPU8);
		}
		else
		{
			GPIO_Clr(IO_CPU8);
		}
	}

	if(mask & BV(8+16))
	{
		if(value & BV(8+16))
		{
			GPIO_Set(IO_CPU9);
		}
		else
		{
			GPIO_Clr(IO_CPU9);
		}
	}
}



uint32_t srv_gpio_dump(char * buffer, uint32_t buffer_size)
{
  uint32_t length;
  uint32_t in;

  in = srv_gpio_get_io();

  length = snprintf(
		  	  buffer,
			  buffer_size,
			  "GPIO : IN1 %ld IN2 %ld IN3 %ld IN4 %ld IN5 %ld IN6 %ld IN7 %ld IN8 %ld IN9 %ld IN10 %ld \r\n"
			  "GPIOE: IO1 %ld IO2 %ld IO3 %ld IO4 %ld IO5 %ld IO6 %ld IO7 %ld IO8 %ld IO9 %ld\r\n"
			  ,
		  (in>>0) & 0x01,
		  (in>>1) & 0x01,
		  (in>>2) & 0x01,
		  (in>>3) & 0x01,
		  (in>>4) & 0x01,
		  (in>>5) & 0x01,
		  (in>>6) & 0x01,
		  (in>>7) & 0x01,
		  (in>>8) & 0x01,
		  (in>>9) & 0x01,

		  (in>>16) & 0x01,
		  (in>>17) & 0x01,
		  (in>>18) & 0x01,
		  (in>>19) & 0x01,
		  (in>>20) & 0x01,
		  (in>>21) & 0x01,
		  (in>>22) & 0x01,
		  (in>>23) & 0x01,
		  (in>>24) & 0x01
  );


  return length;
}


void  srv_gpio_refresh(void)
{
	gpio_pwm.force_update = 1;
}




void  srv_gpio_once(void)
{
	srv_gpio_refresh();

	srv_timer_callback_slow_add(srv_gpio_tick_io);
}
