jarekkt/UniController/software/00_controller/lib_code/engine/motion/motion_scurve.h

#ifndef MOTION_SCURVE_H
#define MOTION_SCURVE_H
 
#include "system.h"
#include "motion_engine.h"


typedef struct
{
	float T1;  		   // Speed  increase
	float T2;  		   // Constant speed
	//float T3;  	   // Speed  decrease - Note: equal to T1

	float T11,T12,T13; // Concave, linear and convex period

	float T11_s;	   // Distance for T11 phase
	float T11_v;	   // Speed at the end of T11 phase

	float T12_s;	   // Distance for T12 phase
	float T12_v;	   // Speed at the end of T12 phase

	float T13_s;	   // Distance for T13 phase
	float T13_v;	   // Speed at the end of T13 phase

	float T1_s;		   // Distance for T1 phase
	float T2_s;		   // Distance for T2 phase

	float accel;
	float speed;
	float speed_start;
	float jerk;

	int32_t dir;


}motion_calc_t;



void motion_scurve_calc(
		motion_calc_t * calc,
		float 			dist_mm,
		float 			speed_safe_mm_s,
		float 			speed_mm_s,
		float 			accel_mm_s2,
		float 			jerk_mm_s3
);

int32_t motion_scurve_test(uint32_t test_nr);
int32_t motion_scurve_test_all(void);


#endif // MOTION_SCURVE_H
