jarekkt/UniController/software/00_controller/lib_code/engine/motion/motion_eq.h

#ifndef MOTION_EQ_H
#define MOTION_EQ_H
 
#include "system.h"

int32_t cubic_eq(double a1, double b, double c, double d, double * results);
int32_t quad_eq(double a, double b, double c, double * results);



#endif // MOTION_EQ_H
