jarekkt/UniController/software/00_controller/lib_code/services/adc/adc_srv.c

#include "adc_srv.h"





volatile uint32_t adc_vars[ADC_CH_CNT] __attribute__ ((section (".dma")));

extern ADC_HandleTypeDef hadc1;
extern ADC_HandleTypeDef hadc3;

void      srv_adc_init(void)
{

  if (HAL_ADCEx_Calibration_Start(&hadc3, ADC_CALIB_OFFSET, ADC_SINGLE_ENDED) != HAL_OK)
  {
	 fw_assert(0);
  }


  if(HAL_ADC_Start_DMA(&hadc3, (uint32_t*)&adc_vars[0], ADC_CH_CNT) != HAL_OK)
  {
	 /* Start Error */
	 fw_assert(0);
  }
}

void      srv_adc_once(void)
{

}


uint32_t  srv_adc_get(uint32_t ch)
{
    if(ch < ADC_CH_CNT)
    {
        return (uint32_t)adc_vars[ch];
    }
    else
    {
        return 0;
    }

}

uint32_t srv_adc_dump(char * buffer, uint32_t buffer_size)
{
  uint32_t length;

  length = snprintf(buffer,buffer_size,"ADC: IN1 %4lu IN2 %4lu\r\n",
      adc_vars[ADC_IN1],
      adc_vars[ADC_IN1]
     );


  return length;
}
