jarekkt/UniController/(commit log)

2021-01-11 Files added
    [615006138521.stp, 7-188275-8.stp, 95522-2667.stp, ABM7.STEP, Analog_digital_io.kicad_sch, B3U-1000P-B.stl, B3U-1000P-B.stp, B3U-3100P-B.stp]
2021-01-13 UPDATE - LAN chipset waiting for verification
    [Analog_digital_io.kicad_sch, Digital_in.kicad_sch, Encoder.kicad_sch, Outputs.kicad_sch, Power_supply.kicad_sch, RS485_CAN.kicad_sch, Stepdir.kicad_sch, Uni_Printer.kicad_pcb]
2021-01-14 UPDATE - LAN corrections
    [Uni_Printer.kicad_pcb]
2021-01-19 UPDATE - Traces finished
    [Analog_digital_io.kicad_sch, Encoder.kicad_sch, Outputs.kicad_sch, Power_supply.kicad_sch, Uni_Printer.kicad_pcb, Uni_Printer.kicad_sch, ethernet.kicad_sch, processor.kicad_sch]
2021-01-25 UPDATE - finished
    [Uni_stick.kicad_pcb]
2021-02-01 UPDATE - Uni_stick the rest of files
    [TME.csv, Uni_stick.kicad_sch]
2021-02-04 Added software files - from previous prototype
    [615006138521.stp, 7-188275-8.stp, 95522-2667.stp, ABM7.STEP, Analog_digital_io.kicad_sch, B3U-1000P-B.stl, B3U-1000P-B.stp, B3U-3100P-B.stp]
2021-02-04 Changes in directories
    [615006138521.stp, 7-188275-8.stp, 95522-2667.stp, ABM7.STEP, Analog_digital_io.kicad_sch, B3U-1000P-B.stl, B3U-1000P-B.stp, B3U-3100P-B.stp]
2021-02-07 Debug uart added
    [Analog_digital_io.kicad_sch, Digital_in.kicad_sch, Encoder.kicad_sch, Outputs.kicad_sch, Power_supply.kicad_sch, RS485_CAN.kicad_sch, Stepdir.kicad_sch, Uni_Printer.kicad_pcb]
2021-02-17 UPDATE - 3D and Jumper descriptions
    [ABRACON_ABM7-8.000MHZ-D2Y-T.STEP, Analog_digital_io.kicad_sch, Digital_in.kicad_sch, Encoder.kicad_sch, HANRUN HY911130A.STEP, Inductor IHLP SMD 2020 10uH.stp, Inductor IHLP SMD 2525 10uH.stp, Inductor IHLP SMD 6767 10uH.stp]
2021-02-17 Fixes after wrong merge
    [Analog_digital_io.kicad_sch, Digital_in.kicad_sch, Encoder.kicad_sch, Outputs.kicad_sch, Power_supply.kicad_sch, RJ45-Female.STEP, RS485_CAN.kicad_sch, Stepdir.kicad_sch]
2021-02-17 UPDATE - stick
    [Uni_stick.kicad_pcb]
2021-02-18 Fixes before ordering PCB
    [MPXH6115AC6U.stp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]
2021-02-20 More fixes for ethernet and USB
    [main.c, main.h, srv_gpio.c]
2021-02-24 Fixes for new hw version
    [Digital_in.kicad_sch, Uni_Printer.kicad_pcb, Uni_Printer.kicad_sch, processor.kicad_sch]
2021-03-03 Fixes in net support
    [motion_engine.c, motion_engine.h]
2021-04-01 Fixes in memory layout ( for eth DMA )
2021-04-05 Implementing missing gcode support
    [adc_srv.c, main.c, motion_engine.c]
2021-04-06 Fixes in FreeRtos ocnfiguration and netowrking
    [main.c]
2021-04-06 Fix in ethernet callbacks
    [motion_engine.c]
2021-12-07 Remote mode fixes
    [Analog_digital_io.kicad_sch, Digital_in.kicad_sch, Encoder.kicad_sch, Outputs.kicad_sch, Power_supply.kicad_sch, RS485_CAN.kicad_sch, Stepdir.kicad_sch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]
2022-01-07 FW and SW updates for new revision
    [7-188275-8.stp, Analog_digital_io.kicad_sch, DRV 8825 Assem.STEP, DRV 8825 With Headers Assem.STEP, Digital_in.kicad_sch, Encoder.kicad_sch, MPX.stp, MPX5010DP.stl]
2022-01-08 Fixes in ethernet and USB communication
    [main.c, motion_engine.c, serial_srv.c]
2022-06-14 New idea for controller - new hw principle
    [091X510X904_100081317MOD000B.STP, 615006138521.stp, 7-188275-8.stp, 95522-2667.stp, ABM7.STEP, ABRACON_ABM7-8.000MHZ-D2Y-T.STEP, Analog_digital_io.kicad_sch, B3U-1000P-B.stl]
2022-06-19 Fixes in PCB
    [UniPrinterBase.kicad_sch, Uni_Printer.kicad_pcb, controller.kicad_sch, shield_chm36VA.kicad_pcb, shield_chm36VA.kicad_sch]
2022-06-19 More fixes in PCB
    [shield_chm36VA.kicad_pcb]
2022-06-19 Removed CAN and RS485 drivers
    [Uni_Printer.kicad_pcb, Uni_Printer.kicad_sch, processor.kicad_sch]
2022-06-20 Fixes in PCB design
    [Uni_Printer.kicad_pcb, Uni_Printer.kicad_sch, processor.kicad_sch]
2022-07-13 Prepared for first prototype
    [UniPrinterBase.kicad_sch, Uni_Printer.kicad_pcb, Uni_Printer.kicad_sch, controller.kicad_sch, shield_chm36VA.kicad_pcb]
2022-07-29 Fixes after first power on - both software (ethernet reset) and hardware ( resistor values)
    [Uni_Printer.kicad_pcb, Uni_Printer.kicad_sch]
2022-09-30 Fixes for IO configuration. First configuration for CHM36VA
    [motion_engine.c]
2022-10-07 Added incremental moves needd for homing. Homing fully implemented
2022-10-13 Fixes in end position control ( both from inputs and soft limits)
    [motion_engine.c, motion_engine.h, params.c]
2022-10-17 Fixes in timers and io processing
    [motion_engine.c, params.c, params_chm36va.c, timer_pulse.h, timer_srv.c]
2022-10-19 Hardware assisted pulse generation fixed
    [motion_engine.c, time_pulse.c, timer_pulse.h]
2022-10-20 Fixed G code parsing checks
    [motion_engine.c]
2022-10-30 Fixes in pulse calculations - floating point version
    [motion_engine.c, motion_engine.h, motion_engine_calc.c, motion_engine_pins.c, motion_scurve.c, params.c]
2022-11-18 Fixes in movement calculation. homing procedure fixed
    [091X510X904_100081317MOD000B.STP, B6P-VH_LF__SN_.stp, JST - VH - Thru (V) - 10Pin - 3.96mm.stp, JST - VH - Thru (V) - 11Pin - 3.96mm.stp, JST - VH - Thru (V) - 12Pin - 3.96mm.stp, JST - VH - Thru (V) - 2Pin - 3.96mm.stp, JST - VH - Thru (V) - 3Pin - 3.96mm.stp, JST - VH - Thru (V) - 4Pin - 3.96mm.stp]
2022-11-22 More fixes for homing
    [motion_engine.c, motion_engine.h]
2022-11-23 Fixed issue with 1.9.1 drivers version and stratup file
    [main.c]
2022-11-23 Fixes in ADC, encoders
    [adc_srv.c, main.h, motion_engine.c, motion_engine.h, srv_gpio.c]
2022-11-23 Fixes in timer allocation
    [adc_srv.c, timer_srv.c]
2022-12-01 Schematics fixes - frewheeling diodes
    [UniPrinterBase.kicad_sch, controller.kicad_sch, shield_chm36VA.kicad_pcb, shield_chm36VA.kicad_sch]
2022-12-01 Cleanup in timers
2022-12-07 1.New shield version 1.1
    [UniPrinterBase.kicad_sch, controller.kicad_sch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]
2023-05-22 Added pdf for schematics. Updated project files for newest Kicad
    [Power_supply.kicad_sch, UniPrinterBase.kicad_sch, Uni_Printer.kicad_sch, controller.kicad_sch, ethernet.kicad_sch, processor.kicad_sch, shield_chm36VA.kicad_pcb, shield_chm36VA.kicad_sch]
2024-10-20 New idea - mix project will take over
    [Power_supply.kicad_sch, Uni_Printer.kicad_sch, ethernet.kicad_sch, processor.kicad_sch]
2024-10-20 Cleanup. Mixture project as leading one.
    [091X510X904_100081317MOD000B.STP, 615006138521.stp, 7-188275-8.stp, 95522-2667.stp, ABM7.STEP, ABRACON_ABM7-8.000MHZ-D2Y-T.STEP, B3U-1000P-B.stl, B3U-1000P-B.stp]
2024-10-20 Added hardware files
    [05200101Z.stp, 3557-2.step, AP7375-50W5-7.stp, D-SUN_dcdc_step_down_SIMPLE.step, D-SUN_dcdc_step_down_Simple_NoSilk_.step, THVD1400DRLR.stp, TMC2209-LA-T.stp, TMC2209_SILENTSTEPSTICK.step]
2024-10-20 Github link added to PCB texts
    [UniMixBase.kicad_pcb]
2025-02-07 Upadtes for Nucleo version
    [05200101Z.stp, 3557-2.step, D-SUN_dcdc_step_down_SIMPLE.step, D-SUN_dcdc_step_down_Simple_NoSilk_.step, LPC11C22FBD48_301,.stp, THVD1400DRLR.stp, TMC2209_SILENTSTEPSTICK.step, UniMixBase.kicad_pcb]
2025-02-12 Updated hardware design
    [UniMixBase.kicad_pcb, UniMixBase.kicad_sch]
2025-05-28 CAN FD head added
    [MB1430-G431KBT6-A02.step, UniMixBase.kicad_pcb, UniMixBase.kicad_sch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]
