jarekkt/UniController/(notices)

Notices in the files:
software/00_controller/lib_boards/Nucleo-H755ZI-Q/CM7/Core/Src/main.c:
Copyright (c) 2025 STMicroelectronics.
All rights reserved.
This software is licensed under terms that can be found in the LICENSE file
